secarider/SNAPACK/hardware_manifest_revised.txt

=========================================================
SNAPACK PROJECT GOAL AND
MASTER HARDWARE MANIFEST
WITH BUILD NOTES AND THOUGHTS

=========================================================
PIN MAP REFERENCE
=========================================================
The Authoritative Pin Map Supersedes Any Older Or Conflicting
Pin Number References.
01_Pin_Maps_Authoritative.txt

All ELECROW 2.1 ESP32 Rotary Display 
480x480 HMI IPS Round Knob Touch Display
Pin Numbers Refer To The 12-Pin Ribbon Cable
Connector Pin Numbers Identified By The Silkscreen On The Back
Of The Display PCB.

---------------------------------------------------------
HIGH CURRENT PATH
NEGATIVE SWITCHING ONLY.
POSITIVE PATH REMAINS UNINTERRUPTED.
---------------------------------------------------------
Snapack Design:
The Main High Current Positive Path Remains Uninterrupted.
No High Current Fusing Is Provided For Or Expected.
Esp32 Will Access A Lockout Relay To Force Pos+ Control Voltage Cutoff 
When/If Any Set Variables Are Met. Like Temp Or Voltage Drops.
Low Current Control Lockouts Are Not Included And Are Exempt.
=========================================================
Purpose:
Intelligent 12V LiFePO4 Jump Pack w/ 16V Boost 
With Touchscreen HMI, Contactor Control,
Cell Monitoring, Temperature Monitoring,
Current Monitoring Both In And Out, 
Self-Diagnostics, Logging, And Pack Resistance Tracking.
MAX Amps Hold/Show Info Screen Display
Display AMPS Out And Any AMPS In To Calculate From Last "Set Full" Pack
All Terminating End Of Control And Low Current Supplies,
Will Be In The Service Hatch Area If Possible, We Will See.

=========================================================
            SOURCE BATTERIES
=========================================================
Headway 38120 LiFePO4 Cells
Configuration: 5S5P
Pack Volts: 4S (~12V nominal)
Pack Volts: 5S (~16V nominal)
Estimated:  1000 Amp Output Availibility
110spec Copper Bus-Bars 3/16" Thick Throughout
All Contactor Bus-Bars As Well

=========================================================
            CONTACTORS
=========================================================
   Negative Switching Only.
   Positive Path Remains Uninterrupted.
         ==========\/========

EV200               

Qty: 2 In Parallel

Specs:
500A X 2 For 1000A Capacity

Coil Supply Source:
9–36 V Coil With Economizer Operating Range Per Specs.
Power These From Full Pack Voltage 16V

Protection:
Dedicated Positive-Side Fuse

Processor Lockout:
Series Relay In Contactor Banks Positive Coil Feed So Over Temp, Over Amp, Or ?, 
Will Allow For Automatic Shutdown Via ESP32 Controller Via Opto-Isolated 5v SPDT Relay

Hardware Interlocks:
Negative-Side Switched Control Path

Fail-Safe Behavior:
Opening Either Positive Permission Or Negative Control
De-Energizes Power Path For All Contactor Banks, Both EV200 And Lev100.

Purpose:
Full Pack: 5S (~16V Nominal) Main High-Current Contactors

         ==========/\========
   Negative Switching Only.
   Positive Path Remains Uninterrupted.
         ==========\/========

LEV100

Qty: 8 Total

Purpose:
Battery Tap @ 4S (-12V) High Current Path

Specs:
100A X 8 For 800A Capacity Maybe A Little Light But It Is What It Is.
24V Coils
Power For 24V LEV100 Coils Supplied By:
DC 12V To 24V 3A Step Up Boost Converter: <--Feed This From 16V Full Pack Voltage
This Is A Potted Module So No Coating Needed

Protection:
Dedicated Positive-Side Fuse

Processor Lockout:
Series Relay In Positive Coil Feed So Over Temp, Over Amp, Or ?, 
Will Allow For Automatic Shutdown Via ESP32 Controller

Hardware Interlocks:
Negative-Side Switched Control Path

Fail-Safe Behavior:
Opening Either Positive Permission Or Negative Control
De-Energizes Power Path For All Contactors Banks, Both EV200 And Lev100.

Mounting:
4 In Left Wing
4 In Right Wing
110spec Copper Bus-Bars 3/16" Thick Throughout

         ==========/\========
   Negative Switching Only.
   Positive Path Remains Uninterrupted.

=========================================================
            Interlock And Command RELAYS
=========================================================
Automotive SPDT 12v 30A Relay Sockets Included
Qty:4

Protection:
Dedicated Positive-Side Fuse

EEEEE 1N4007 Rectifier/Flyback Diodes:
Relay Terminals 86+ Are Always Positive Coil Supply; 
Relay Terminals 85- Are Always Negative/Control Return. 
Flyback Diode Stripe Always Faces 86 +.
One Diode Installed Across Pins 85- And 86+ Of Each Relay Coil
To Suppress Inductive Voltage Spikes When The Coil Is De-Energized,
Protecting Relay Contacts And Control Electronics.

De-Pinned Both 86 And 85 From 5 Sockets And
Soldered Directly To Wire Crimps, Stripe Toward 86 +.
Four Automotive Relay Sockets Remain Used In The Current Design.
The Fifth Previously Prepared Gatekeeper Socket Is Replaced By The
5V Opto-Isolated Relay Module.

=========================================================
            CONTACTOR INTERLOCK / BREAK-BEFORE-MAKE
=========================================================
Purpose:
Guarantees The LEV 100 Banks 12v Contactor Releases Before
The 16v EV200 Main Boost Path Contactor Is Allowed To Energize.
Must Work For Both Transition To And Detransition From 16v Boost Function

Theory Of Operation:
1 SPDT 12v In Its Relaxed (Unpowered) State Turns The 12v Lev100 Banks Control Relay To Authorized,
Allowing The Timer Switch Signals To Reach The Controls.
The Open Pole Of Same Double Throw Relay Assures 16v EV200 Contactor Is NOT Authorized. 
This Is Probably Sufficient As A Safety Interlock To Insure Either Contactor Bank Can Never Be On At The Same Time,
However,
There Is Concern For The Amount Of Amps Being Pushed At The Moment Of Commanded Contactor 
Switchover Could Pose A Risk (Even If Small) Of The 2 Voltages Running Into Each Other.
Which Could Weld The Contacts Together Microseconds After The Commanded Switchover.
So It Should Be Simple Enough To Introduce A Controlled Delay Long Enough To Guarantee 
12v Contactor Has Released Before The 16v Contactor Can Engage.
The Resultant Burn Down Of A 5p5s Pack From Such An Unlikely (But Not Zero Chance) Event Could Be Quite Energetic
To Say The Least, So Extra Precautions Are Being Employed By Stretching Out
The Sequence Using 2 Relays To Double The Time Alotted For Contactor Disconnect Before Connect 
" Break For Sure Before Make " And Still Accomplish The Switchover In No Less Than <50ms No More Than >100 milliseconds
And Works For Both Transition To And Detransition From 16v Boost Function.

Function:
12V OFF
    ↓
Delay By Dual Consecutive Relay, NOT DBL Throw, 
An Actual 2nd Relay For Pole/Pivot Transit Travel Time x2 
Best Guess This Will Give Us >50ms Delay, 
This Provides The Same Delay In Both Directions.
Hopefully Preventing Pack Shorting By Contact Overlap 
Resulting In Welded Contactors From An Accidental Make-Before-Break. 
Unlikely, But Not Zero Chance So... Extra Precautions Are Being Employed.
    ↓
16V ON

Location:
Service Hatch

       [ RELAY 1: 12V POLICE ]                   [ RELAY 2: 16V POLICE ]
  ┌────────────────────────────────┐       ┌────────────────────────────────┐
  │ Pin 85: GND                    │       │ Pin 85: GND                    │
  │ Pin 86: 12V Mode Switch Signal │       │ Pin 86: 16V Mode Switch Signal │
  │ Pin 30: Master Control Power   │       │ Pin 30: Master Control Power   │
  │ Pin 87a (NC): Wire to R2 Pin 30│       │ Pin 87a (NC): Wire to R1 Pin 30│
  │ Pin 87 (NO): To LEV100 Coils   │       │ Pin 87 (NO): To EV200 Coils    │
  └────────────────────────────────┘       └────────────────────────────────┘
The 12V Path Logic: 
Run The Main Control Power Into Relay 2, Pin 30. 
Run A Wire From Its Normally Closed Contact (Pin 87a) Over To Relay 1, Pin 30. 
Finally, Run Relay 1'S Normally Open Contact (Pin 87) Out To The LEV100 Contactor Coils.

The 16V Path Logic: 
Mirror The Exact Same Step On The Other Side. Run Main Control Power Into Relay 1, Pin 30. 
Run A Wire From Its Normally Closed Contact (Pin 87a) Over To Relay 2, Pin 30. 
Then, Run Relay 2'S Normally Open Contact (Pin 87) Out To The Big EV200 Contactor Coils.

The ESP32 Output Sense Wire Can Double-Check These Exact Millisecond Speeds During Bench Mockup?

=========================================================
            Processor Commanded Lockout:
=========================================================
The ADS1115 ALERT Output Does NOT Directly Energize A Relay Coil.

A Single-Channel 5V Opto-Isolated Relay Module Is Used As The Interface:
AITRIP 5V One Channel Relay Module
Opto Isolation / High-Low Level Trigger
ASIN: B096M77HCJ

The Module Contains Its Own Relay Driver And Flyback Protection,
So The ADS1115 ALERT Signal Does Not Carry Relay-Coil Current.

The Relay Contacts Are Wired Into The Positive Contactor Authorization Path.
The Authorized State Uses The Relaxed (Non-Powered) Relay Contact Arrangement That Allows The Pack
To Operate Without The Processor Actively Holding A Relay Coil Energized.

Upon A Processor / ALERT Shutdown Command, The Opto Relay Module Is Activated And Interrupts
The Positive Authorization Path And De-Energizes Both Contactor Banks.

This Module Replaces The Previously Proposed Automotive Gatekeeper Relay.

=========================================================
            CURRENT MONITORING
=========================================================
OTC 3500-01 Clamp
2000A Mode Only
OTC_ZERO_OFFSET = 3.620

The OTC 3500-01) Operate On A Strict, Direct Scaling Ratio: 1mV = 1amp

Fixed on 2000A range:
ThumbWheel Calibrated To Zero By Meter And Then Hot Glue Dollip To Imobilize Wheel Adj.
Will Zero From SoftWare In Future

Plan:
Install Internally On Positive Side
JST 9 Pin Header Added To Extend Delicate Clamp Connected Ribbon Cables
8 Factory Pins And 1 Extra
Function: Cable Shield / Drain
Connection: System Ground
Purpose: EMI shield termination only.
Pin 9 Not a signal conductor.
PCB cleaned after soldering.
PCB protected with conformal coating.
Ribbon cable strain-relieved at clamp body.
JST 9 Pin female connector attached to the OEM ribbon cable header from OEM Circuit Board
This created a 8 inch extension for the OEM Circuit Board to exist further away from clamp
Clamp orientation established during mock-up.
3.3v limits have forced orientation to a discharge = DECREASE in voltage as discharge is the most energetic 
Permanent 9V Power Supply Has Been Provided.

This Small OTC Supply Assembly Will Go On The 
Perf-Board With The Voltage Divider

Input Wires From The Waterproof 5 V Buck
Feeding Into A B0509S-1WR3 DC-DC 5V to 9V Isolated Power Converter
Output Wires To The OTC Electronics Battery Connections

The Waterproof 5 V Buck Is A Separate Potted Module And 
Does Not Need To Be Mounted On That Perf-Board.

=========================================================
            PROTECTION
=========================================================
The P6KE18A Is A Transient Voltage Suppressor (TVS) Diode. 
Under Normal Conditions, It Sits Completely Dormant And Invisible. 
However, If A Massive Voltage Spike 
(Like A Starter Motor Inductive Kickback Or A Surface Charge Surge) 
Hits The System, It Snaps Alive Instantly To Clamp And Shunt That Energy Safely 
To Ground Before It Can Travel Down The Small Signal Wires
Because The 5S Full Pack Max Voltage Is 18.25V, 
We Have Selected An 18V TVS To Act As A Threshold Guard.
On The Divider Board Right Before The Signal Hits The Resistors. 
They Belong Directly Across Each Raw Incoming Protected Voltage Sense Line:
The Five Cumulative Battery Taps Plus Final Output Positive And Final Output Negative.
Stripe To Positive With All Of Their Ends At System Ground.

=========================================================
            Analog Front-End Board (Voltage Divider)
=========================================================
ADS1115

Reads:
5 Cumulative Pack Voltages
24 Volt Rail
OTC Current Sensor
Final Output Positive Voltage
Final Output Negative Voltage

B0 = pack negative / system reference
B1 = first cumulative cell tap
B2 = second cumulative cell tap
B3 = third cumulative cell tap
B4 = fourth cumulative cell tap
B5 = pack positive

Individual cell voltages are derived from these cumulative
measurements.

Current proven divider architecture:

B1:
47k high / 18k low

B2:
47k high / 18k low

B3:
47k high / 18k low

B4:
100k high / 10k low

B5:
100k high / 10k low

Design maximum cumulative voltages:

B1 = 3.65 V
B2 = 7.30 V
B3 = 10.95 V
B4 = 14.60 V
B5 = 18.25 V

These values describe the present proven implementation and required
measurement ranges.

============================================================
          ADS1115 AUTHORITATIVE CHANNEL MAP
============================================================
CHANNEL ALLOCATION
============================================================
Board 1 — 0x48 jumper directly between ADDR Pin To SYS GND
A0 = B1 3.3
A1 = B2 6.6
A2 = B3 9.9
A3 = B4 12.8
this is all 4 cells that make 12v on one board

ALERT Wired And Available

------------------------------------------------------------

Board 2 — 0x49 jumper directly between ADDR Pin To 5v+ VDD
A0 = B5 Pack Positive + 16.0
A1 = CDS/light sensor
A2 = OTC Current
A3 = 24 V LEV100 supply monitor

ALERT Wired And Available

------------------------------------------------------------

Board 3 — 0x4A jumper directly between ADDR Pin To SDA

A? =    Final Output +
A? =    Final Output −
two spare channels remaining

ALERT Wired And Available

Board 1 = 0x48 jumper directly between ADDR Pin To SYS GND
Board 2 = 0x49 jumper directly between ADDR Pin To 5v+ VDD
Board 3 = 0x4A jumper directly between ADDR Pin To SDA
Board 4 = 0x4B jumper directly between ADDR Pin To SCL

-------------------------------------------------------

Sense Wire Locations:
Final Output (+): Last Internal Positive Connection Before The Jump Cable Leaves The Pack
Final Output (-): Last Internal Negative Connection Before The Jump Cable Leaves The Pack
Obtain These From Last High Current Connection
Do Not Obtain These From Any Other Location
Use Bigger Wire As Well

The Two Final Output Sense Channels Use The Same
47k / 18k / 100nF / P6KE18A Protected Divider Circuit  ---------------------------------??
As The Five Existing Cumulative Pack Voltage Channels.

Single Row Divider Sketch: 1 Each Protected Voltage Input = x7
(5 Cumulative Pack Voltage Inputs + Final Output Positive + Final Output Negative) =7

               TVS Protection Shield
                    +    |  \/      +        +                    +      +      +
BMS TAP ───| |───────────●──────────────────►[ 47kΩ Resistor ] <───●─WIRE/HOLE────────► To ADS1115 Pin
            |           +│\                /                     +│\                /
            |           +│ * SAME HOLE AS *                      +│ * SAME HOLE AS *                                  
            |           +│    +/\+               +/\+            +│
            |           +│     ││                 ││             +│────────────┐
        Isolation   [ P6KE18A ] \ (Stripe To Pos) /            [ 18kΩ ]     [ 100nF ]
          Relay       TVS Diode                                  Lower        Filter
                   OBSERVE POLARITY                             Resistor     Capacitor
                        -│                                       -│────────────┘      
                        -│                                       -│
                        -│                                       -│           -
SYSTEM GND ──────────────┴────────────────────────────────────────┴──────────────────► SYSTEM GND
                        -                                        -            -
Battery tap
    |
    +---- TVS ---- GND
    |
   47k
    |
    +------------ ADS A0/A1/A2/A3
    |          |
   18k        100nF
    |          |
   GND        GND

ADS A-channel  <-- divider/filter junction -->   COMMON GROUND
                           ^
                           |
                      cell input

The End Of The P6KE18A Diode With The Painted Stripe Must Face Each Positive BMS Tap Wire
All TVS Diodes Terminate At Sys Ground. 

=========================================================
            TEMPERATURE
=========================================================
DS18B20 Probes
Qty: 5

Locations: Temp Sensors
1 Sensor At Main POS Cable Connection: There Is Only 1 Bar-To-Cable Connection On The Positive Path, Sensor Is Located Here.
1 Sensor At Main Neg Location: It Is The First Bar-To-Cable For Neg Line At Cell Interface.
Contactors:  1 Sensor In-Between Or Near EV200 Bus Bar Connections: This Neg Location Is Where The Second Cable-To-Bar 
Connection And Is Also Where The External Jump Cable Will Connect
2 For Lev100 Banks: 1 In Each Wing
Probe Locations Are Approximate And Subject To Last Min Change As Fitting And Access Allows
These Are At Bar-To-Cable Connections Not For Contactor Temps But Cable Connection To Bar Temps
As We Theorize A High Temp At Any Single Connection Point Is Reason To Stop Using The Pack And Investigate

DS18B20 Sensors Daisy-Chain Directly:
3.3V
GND
DATA
Common One-Wire Bus
Sensors Daisy-Chain Directly.

The 3.3V Supply:
The AMS1117-3.3 Regulator Module Is Fed From The Main Regulated 5V Rail.
Its Regulated 3.3V Output Powers The Level Shifter LV Pin, The Five
Temperature Sensor Red VCC Wires, And The Top Of The 4.7kΩ OneWire Pull-Up.

The Data Node:
The Bottom Leg Of The 4.7kΩ Pull-Up Resistor Ties To The Five Yellow
Temperature Sensor Data Wires And Output Header Pin 8.
Output Header Pin 8 Routes To 12-Pin Ribbon Pin 6 (TX).

The Ground Node:
The Five Black Temperature Sensor Wires And AMS1117 Ground Return
To System Ground.

AMS1117-3.3 REGULATOR NOTES

Input:
Main Regulated 5V Rail

Ground:
System Ground

Output:
Regulated 3.3V Rail

The Selected AMS1117-3.3 Module Includes Its Own Onboard
Input / Output Bypass Components.

=========================================================
            TIMING: Pack Time On
      This Is NOT Contactor Lockout Timing
=========================================================
Briidea Livewell Timer Switch ASIN 	B0F5H3MDRS
Marine Quality Livewell Switch With 
1-12 Min Rotary Adjustment Knob
Rocker Switch Center Off, Timer, *Always On* <----*
* Remove Continuous ON Position To Ensure Pack Can NEVER Be Left On 
And Will ALWAYS Turn Itself Off After Timer Expires*
Depending On Switch Mount Location 
A Different Switch Can Be Employed
So No Dead Zone Switch Need Be Used As 
The Switch In This Timer Module Is Removable. Yay!

Leave:
OFF And TIMER Positions Active Only
This Is The Main Arm/Disarm Switch.
Knob Should Be Turned Down All The Way For Storage 
So Even If Button Is Bumped On Pack Will Still Not 
"Stay" On Long And Automaticlly Turns It Self Off.

=========================================================
            USB / ACCESSORIES External User Access
=========================================================
12V Accessory Socket
USB-A / USB-C Charger With Voltmeter
Actual Retro 12V Cigarette Lighter , maybe , not
Wing LED Lights
All Power Is Constrained By The Timer, 
Even Power To These Accessories.
There Will Be No Paths Of Power That Can 
Lead To Accidental Pack Depletion.

=========================================================
            DISPLAY / CONTROLLER
=========================================================
ELECROW ESP32-S3 Round Display
Model Number 	DHE03921D
480x480 Touchscreen

Rotary Encoder:
(Push + Rotate)
Depending On Installation Difficulty 
It May Be Display ONLY Without Push Or Rotate
It Is A Touch Screen So Will Still Be Functional Enough For Our Needs

Removable Cable Harnesses:
(NO Soldering Directly To Display PCB)
PCB Has Plugs For Connecting Power And Signal But 
We Now Have The 12Pin Ribbon Cable For All Connections In One Breakout Board
The Ribbon Connector At The Display Is Very Weak 
Don't Be Rough Or You Won't Have A Locking Tab For Your Ribbon Cable
The Breakout Board Has A much More Usable Locking Tab So Disconnect From It If You Can
So That Is Going To Be Our Disconnect 
And Perhaps Still Think About A Light Conformal Coating For The Display PCB To Help 
Weather-Resist It And These Connections From Dirt, Humidity And The Green Crusties

12-Pin Ribbon Connector Pin Map:

See:
01_Pin_Maps_Authoritative.txt

All Pin Numbers Refer To The Silkscreen Numbering On The Back Of
The ELECROW Display PCB. The Breakout Board Is A Straight-Through
Extension And Does Not Introduce A Separate Pin Numbering System.

Keep In Mind Any Connection To A "Live" Side
Should Be The Female Connection.
Male Connects For Passive Side.

=========================================================
            WIRE NUMBER INDEX
=========================================================

Wire Numbering Paradigm:

Single Digit Number Indicates The System / Section Origin.
The Two-Digit Number Identifies The Individual Physical Wire
Within That System.

Wire Numbers Are Assigned To Physical Conductors, Not Merely
To Functions Or Devices.

The List Below Is The Current Working Wire Plan.
Individual Entries Should Be Verified Against The Physical
Build During Mockup And Assembly.

Worksheet Info To Verify For Each Wire:

Wire No:
Signal Name:
Source Device And Terminal:
Destination Device And Terminal:
Normal/Default Voltage Or State:
Wire Color If Helpful:
Wire Gauge If Helpful:
Connector And Pin:
Notes:

1.xx-  Low Current Lockout Control Relays

1.01    +12V Relay Supply
1.02    Ground Relay Supply
1.03    12V Permission Relay Coil +
1.04    12V Permission Relay Coil -
1.05    16V Permission Relay Coil +
1.06    16V Permission Relay Coil -
1.07    Break-Before-Make Timer Input
1.08    Break-Before-Make Timer Output
1.09    Processor Lockout / ADS1115 ALERT Control
1.10    Processor Lockout Relay Status

2.xx-  High Current Contactor Coils / Feedback

2.01    EV200 Coil +   Full Pack Voltage 16V Is Used To Fire These
2.02    EV200 Coil -

LEV100's Use 24VDC Coils Supplied From A 12V To 24V Converter

2.10    LEV100 Coil Supply +
2.11    LEV100 Coil Return -

LEV100 Auxiliary Contact Wiring:
Reserved Pending Physical Implementation And Verification.

3.xx-  Temperature Sensors

3.01    OneWire DATA
3.02    +3.3V
3.03    System Ground

Temperature Sensor Identification / Location:

3.10    POS+ Bus Sensor
3.11    NEG- Bus Sensor
3.12    EV200 Bus Sensor
3.13    LEV Left Sensor
3.14    LEV Right Sensor

3.10 Through 3.14 Identify The Five Physical Sensors / Locations.
They Do Not Represent Five Additional OneWire Data Conductors.

4.xx-  Display

4.01    +5V
4.02    System Ground
4.03    SCL
4.04    SDA
4.05    Temperature Sensor DATA / Display TX

USB D+ And D- Are Unconnected And Therefore Are Not Assigned
Physical Wire Numbers Here.

5.xx-  Battery / Voltage Sense

5.01    B0 / Pack Ground
5.02    B1
5.03    B2
5.04    B3
5.05    B4
5.06    B5

5.10    Final Output Voltage Sense (+)
        Final Positive Connection Before Jump Cable Leaves Pack
        → Output Header Pin 9
        → Protected Divider
        → ADS1115 Board 2 A1

5.11    Final Output Voltage Sense (-)
        Final Negative Connection Before Jump Cable Leaves Pack
        → Output Header Pin 10
        → Protected Divider
        → ADS1115 Board 2 A3

6.xx-  Accessory Power

DC 5V, 9V, And 24V Arrive From Dedicated Onboard
Buck / Boost Supplies, NOT Direct Battery Taps.
12V And 16V Are Battery Tapped.

6.01    5V Main
        5VDC Output From 12V To 5V Converter

6.02    5V Ground
        Same As System Ground

6.03    9V Isolated +
        OTC Amp Clamp Power +

6.04    9V Isolated -
        OTC Amp Clamp Power -

6.05    24V LEV100 +
        Output From 12V To 24V Converter

6.06    24V LEV100 -
        Same As System Ground

6.07    12V Raw
        Direct Battery Tap
        Powers Onboard Converters

6.08    12V Ground
        Same As System Ground

6.09    3.3V Regulated
        AMS1117-3.3 Output

6.10    3.3V Ground
        Same As System Ground

7.xx-  Current Sensor (OTC)

7.01    OTC Analog Signal
        OTC Sensor Output → ADS1115 Board 2 A2

7.02    OTC Isolated -9V / Signal Return

7.03    OTC Isolated +9V

7.04    OTC Cable Shield / Drain
        → System Ground At Electronics End

8.xx-  User Controls

8.01    Main Timer Switch
8.02    BOOST Button
8.03    ARM Switch
8.04    Service Override (Reserved)

9.xx-  Future Expansion

LEV100 Auxiliary Contact Input
Reserved Pending Physical Implementation And Verification.

Heater Pad Integration
Reserved If Adopted.

=========================================================
            WIRE NUMBER VERIFICATION
=========================================================

During Mockup / Final Assembly:

Verify That Each Number Represents A Real Physical Conductor.

Verify Source And Destination With The Meter Where Applicable.

Record Connector And Pin Assignments.

Record Wire Color And Gauge Where Useful.

Remove Any Planned Entry That Does Not Exist In The
Completed Physical Build.

Once Verified, This Index Becomes The Source For:

09_Wire_Number_Index.txt

=========================================================
------------------------------------------------------------
24V LEV100 COIL-SUPPLY MONITORING
------------------------------------------------------------

A Dedicated Protected Divider Shall Be Used Because The Existing
47k / 18k Pack-Voltage Divider Is Not Suitable For The 24V Rail.

24V RAIL ─────────●────────► [100kΩ] ─────●────► ADS1115 Board 3 / A0
      SAME HOLE AS│                       │SAME HOLE AS
                [TVS]P6KE27A            [10k]
                  │    SAME HOLE AS       │
SYSTEM GND ───────┴───────────────────────┴────► SYSTEM GND

Candidate Divider Pending Converter Maximum-Voltage Verification:

Upper Resistor: 100k
Lower Resistor: 10k
Filter Capacitor: 100nF

A Higher-Voltage TVS Appropriate For The 24V Rail Shall Replace
The P6KE18A Used On The Existing Lower-Voltage Sense Channels.

P6KE27A
Axial Unidirectional Channel 600 Watt 27 Volt TVS Transient Suppression Diodes 

========================================================================================================================
BMS ISOLATION RELAY 12V SUPPLY

The Isolation Relays Energize Whenever SNAPACK Is Powered.
Processor Authorization Is Not Required.

========================================================================================================================

AMBIENT LIGHT SENSOR / AUTOMATIC DAY-NIGHT DISPLAY THEME:

Sensor:
GL5528 5mm CdS Photoresistor / LDR

GL5528 Relevant Specifications:
Light Resistance @ 10 Lux: 10-20kΩ
Spectral Peak: 540nm
Maximum Voltage: 150V DC
Maximum Dissipation: 100mW
Operating Temperature: -30°C To +70°C

Purpose:
Provides Ambient-Light Level To The ESP32 Through ADS1115 Board 3.
Firmware Uses The Reading To Select Between Day And Night Display Themes.

The Sensor Is Not Intended To Measure Calibrated Lux.
Actual Day/Night Switching Thresholds Will Be Established In Firmware
Using Readings From The Finished Installation.

Voltage Divider:

Regulated 3.3V
     |
 [ GL5528 ]
     |
     +--------------------> ADS1115 Board 3 / A1
     |
   [ 10kΩ ]
     |
  SYS GND

Physical Light Pipe:

3/16" (4.76mm) Clear Acrylic Round Rod
Used As A Light Pipe From The Exterior Of The SNAPACK Enclosure
To The 5mm Face Of The Internally Mounted GL5528.

The Exterior End Of The Acrylic Rod Is Exposed To Ambient Light.
The GL5528 Remains Inside The Enclosure.

The Interior Length Of The Acrylic Rod May Be Covered With Opaque
Tubing Or Black Heat-Shrink To Reduce Light Pickup From The Display
And Other Internal Light Sources.

========================================================================================================================
        PROPOSED / UNDER CONSIDERATION
========================================================================================================================

The Following Items Are Design Concepts Under Evaluation.
They Are Not Yet Implemented Hardware And Shall Not Supersede
The Authoritative Built-Hardware Specifications Until Adopted.

------------------------------------------------------------
PROCESSOR-FAILURE MANUAL OVERRIDE
------------------------------------------------------------

Consider External Weather-Resistant Key Switch Providing
Manual Bypass Of Processor Authorization.

Purpose:

Permit Basic Manual Pack Operation If The ESP32 / Display /
Controller System Is Unavailable.

The Override Would Restore Manual Authorization while retaining
the existing hardware interlock / mode-selection architecture.

Final Switch, Wiring, And Implementation Not Yet Selected.

PROPOSED FEATURE — POST-CRANK RECOVERY / VEHICLE CHARGING

After a successful cranking event, 
SNAPACK may remain connected to the running vehicle and monitor charging current returning from the vehicle charging system.

- Track charge removed during cranking by integrating current over time.
- After engine start, detect current returning to SNAPACK and track recovered charge.
- Display recovery progress and provide a clear indication when the energy used during the crank has been recovered.
- Cells 1–4 / normal 12V section receive charge directly from the vehicle.
- If the 12V section has recovered but Cell Group 5 / boost cell remains low, 
a future small internally controlled isolated LiFePO4 charger may transfer energy from the 12V section to Cell 5.
- This could provide a simple field-charging method: connect SNAPACK to a running vehicle and allow 
SNAPACK to manage its own recovery without specialized shop charging equipment.
- Specialized direct BMS/cell charging remains available for full service/balancing via 6s BMS leads at service hatch

AUTOMATIC DISCONNECT

During vehicle charging/recovery, continuously monitor:
- Charge current and direction
- Individual cell voltages
- Pack voltage
- Temperature sensors
- Recovered charge

When the desired recovery level is reached, or if a configured voltage/current/temperature limit is reached, SNAPACK may remove the authoritative positive relay authorization and open the main contactors, automatically disconnecting itself electrically from the vehicle.

Normal completion and fault-triggered shutdown should be separately identified and logged/displayed.

12-MINUTE HARD LIMIT

The existing 12-minute hardware timer remains authoritative and should not be bypassed for charging.

Software may terminate recovery earlier, but may not extend operation beyond the timer.

The 12-minute window already provides substantial potential recovery from a normally operating vehicle 
charging system and preserves the original hardware-enforced maximum connection time.

CRANKING-SCREEN TEMPERATURE DISPLAY

During an active cranking event, reserve an area near the large cranking-current display for a temperature display
Occupied By The Hottest Sensor And Its #

Normally display average pack temperature or a subdued temperature indication.

If an individual temperature sensor becomes abnormal or begins rising rapidly during a sustained crank, 
immediately replace the normal indication with the affected sensor name and temperature so the 
developing condition is visible without leaving the cranking screen.

CELL 5 MAINTENANCE / TOP-OFF MODE

The proposed isolated Cell-5 LiFePO4 charger does not need to operate only during post-crank vehicle recovery.

Because Cell 5 top-off current will likely be relatively low (~1 A), Cell 5 may recover incrementally over multiple SNAPACK operating sessions.

A user may deliberately activate a normal 12V timer cycle while no vehicle is connected specifically to allow the 12V Cells 1–4 section to top off Cell 5.

Possible logic:

- Normal 12-minute SNAPACK timer is activated.
- No cranking or external vehicle-charging event is occurring.
- Firmware checks Cells 1–4 and Cell 5.
- If the 12V section has adequate available charge and Cell 5 is below its defined target, enable the isolated Cell-5 charger.
- Display indicates BOOST CELL TOP-OFF / Cell 5 voltage / charging status.
- Charger terminates normally when Cell 5 reaches its proper charge condition.
- Existing 12-minute hardware timer remains the absolute maximum session duration.
- Additional 12-minute maintenance sessions may be initiated later if Cell 5 still requires charging.

This allows Cell 5 maintenance while SNAPACK is being transported between jobs and reduces the importance of completing Cell-5 recovery during a single vehicle-charging session.

PROPOSED FEATURE — FIVE-CHANNEL SERVICE CHARGER

Possible future replacement for the present manual five-power-supply charging procedure.

Concept:
- Provide one external DC service-power connection.
- Internally split that source among five independent isolated DC/DC converters.
- Each isolated converter powers one dedicated 1S LiFePO4 charger such as the SK3624 3.6V / 2.4A module.
- Each charger independently charges one 1P5S cell group:

  Charger 1 → B0-B1
  Charger 2 → B1-B2
  Charger 3 → B2-B3
  Charger 4 → B3-B4
  Charger 5 → B4-B5

- The five isolated converter INPUTS may share the same external power source.
- Their OUTPUTS remain isolated so each charger can float at its respective position in the series pack.
- Individual chargers may terminate as their respective cell groups become full while the remaining groups continue charging.
- Approximate maximum combined cell-charging power at 2.4A/channel is ~43W, before conversion losses.

PACKAGING OPTIONS:

1. INTERNAL:
   Five isolated converters + five charger modules installed inside SNAPACK.
   User connects only one ordinary external service-power supply.

2. EXTERNAL:
   If enclosure space becomes insufficient, place the complete five-channel isolated charger system in a dedicated external service-charger box.
   Connect that charger to SNAPACK through the existing B0-B5 service/BMS connection.

This is separate from the proposed automatic onboard Cell-5 recovery charger used during post-crank/maintenance operation.

STATUS: CONCEPT / PACKAGING STUDY
Final implementation depends primarily on available enclosure space.

more charging thoughts 
Board 2 ALERT + pull-up + another AITRIP 5 V opto relay is a very plausible charger-control path.

PROPOSED — AUTOMATIC CELL-5 CHARGE / RECOVERY HARDWARE

PURPOSE

Provide an onboard method of charging Cell Group 5 (B4-B5) from the
normal 12V section without requiring the normal 12V and Cell-5 grounds
to be common.

This supports:
- Post-crank Cell-5 recovery
- Intentional Cell-5 maintenance/top-off sessions
- Opportunistic Cell-5 charging whenever operating conditions permit

PROPOSED POWER PATH

12V section / available SNAPACK power
        |
        v
Cincon EC5DAW-24S05N isolated DC/DC
        |
        |  Isolated regulated 5V / 2A / 10W
        v
SK3624 1S LiFePO4 charger
        |
        +---- BAT+ -> B5
        |
        +---- BAT- -> B4

Cincon EC5DAW-24S05N:
- Input: 9-36VDC
- Output: regulated 5V / 2A
- Power: 10W
- Galvanically isolated
- May therefore be powered directly from the 12V section or from the
  existing 24V rail.

SK3624 charger:
- 1S LiFePO4
- 4.5-5.5V input
- 3.6V charge cutoff
- Up to approximately 2.4A charging
- Internal CC/CV charging and termination
- Approximately 200mA termination threshold
- Automatic recharge below approximately 3.5V

The isolated converter allows the complete SK3624 charger circuit to
float at B4 potential.

CELL-5 CHARGER CONTROL

ADS1115 Board 2 already monitors B5:

Investigate using Board 2 ALERT as the authoritative Cell-5 charger enable/disable signal.

ADS1115 ALERT is open-drain:
- Asserted = actively pulls LOW
- Inactive = releases line / high impedance
- External pull-up establishes HIGH state when released

Proposed control:

Board 2 ALERT
      |
   pull-up
      |
      v
Low-level-trigger opto-isolated relay/control stage
      |
      v
Cell-5 charger power authorization

Desired logic:
- ALERT released / HIGH = CHARGER OFF
- ALERT asserted / LOW = CHARGER ON

Therefore loss of ADS1115 power/configuration or an open ALERT signal
naturally results in charger OFF.

The ESP32 does not directly drive ALERT. It commands Board 2 over the
existing SDA/SCL I2C bus and can rapidly rewrite the ADS1115 comparator
configuration/threshold registers.

Board 2 may continue scanning its four analog channels normally.
When firmware determines that Cell-5 charging is appropriate, it may
reconfigure Board 2 ALERT for the charger-control function.

The SK3624 remains responsible for the actual LiFePO4 CC/CV charging
and normal charge termination. SNAPACK controls whether the charging
subsystem is authorized to operate.

IMPLEMENTATION NOTE

Before finalizing this scheme, bench-test that Board 2 ALERT can be
reliably commanded into both required states through ADS1115 register
configuration while retaining the required multi-channel scanning
behavior.

STATUS: PROPOSED / BENCH TEST REQUIRED
