secarider/SNAPACK/Documentation/10_Hardware_Revision_Log.txt

============================================================
10_HARDWARE_REVISION_LOG.TXT
============================

Revision History

Rev A

Initial Prototype

Rev B

• AMS1117 3.3V Regulator
• Final Output Voltage Sense
• Opto-Isolated ALERT Relay
• Corrected Connector Pin Mapping
• Modular Hardware Specifications

Rev C

• ADS1115 Analog System Changed To 3.3V Operation
• I2C Level Shifter Removed
• Three ADS1115 Board Architecture Established
• Voltage Divider Networks Revised For 3.3V Analog System
• DS2484 I2C-To-1-Wire Temperature Interface Added
• ADS1115 ALERT / AITRIP Contactor Authorization Retained

============================================================

SNAPACK Hardware Specification

Status: Authoritative
Revision: Active

============================================================
PURPOSE
=======

This Specification Records Significant Hardware
Design Changes Made Throughout The SNAPACK Project.

Only Completed And Implemented Hardware Changes
Shall Be Recorded.

============================================================
REVISION FORMAT
===============

Revision

Date (Optional)

Summary

Affected Specifications

Notes (Optional)

============================================================
REVISION HISTORY
================

Revision A

Initial Prototype Construction

---

Revision B

Authoritative Connector Pin Mapping Established

Affected Specifications

01_Authoritative_Pin_Mapping.txt

---

Revision B

Dedicated AMS1117-3.3 Regulated Supply Added

Affected Specifications

02_Power_Architecture.txt

---

Revision B

Final Output Positive Voltage Monitoring Added

Affected Specifications

04_ADS1115_Analog_Front_End.txt

---

Revision B

Final Output Negative Voltage Monitoring Added

Affected Specifications

04_ADS1115_Analog_Front_End.txt

---

Revision B

ADS1115 ALERT Output Changed To Operate Through
AITRIP 5V Opto-Isolated Relay Module

Affected Specifications

04_ADS1115_Analog_Front_End.txt

08_Protection_And_Fault_Response.txt

---

Revision B

Five Temperature Sensor Locations Finalized

Affected Specifications

06_Temperature_Monitoring.txt

---

Revision B

Modular Hardware Specification Set Created

Affected Specifications

All

============================================================
REVISION C
==========

ADS1115 Analog System Changed From 5V To 3.3V Operation

The ADS1115 Boards Now Operate Directly From The
Regulated 3.3V Logic Rail.

Affected Specifications

01_Authoritative_Pin_Mapping.txt

02_Power_Architecture.txt

03_Display_Interface.txt

04_ADS1115_Analog_Front_End.txt

---

I2C Level Shifter Removed

The ADS1115 Analog System And Display I2C Interface
Now Operate In The Same 3.3V Logic Domain.

The Previously Required I2C Level Shifter Is No Longer
Part Of The SNAPACK Hardware Architecture.

Affected Specifications

01_Authoritative_Pin_Mapping.txt

02_Power_Architecture.txt

03_Display_Interface.txt

04_ADS1115_Analog_Front_End.txt

---

Three ADS1115 Board Architecture Established

Three ADS1115 Boards Are Used To Provide The Required
Analog Measurement Channels.

The Third ADS1115 Provides Channels For Final Output
Voltage Monitoring And Additional Expansion Capacity.

Affected Specifications

01_Authoritative_Pin_Mapping.txt

03_Display_Interface.txt

04_ADS1115_Analog_Front_End.txt

---

Voltage Divider Architecture Revised

The Previous Common Divider Arrangement Was Revised
For Operation With The 3.3V ADS1115 Analog System.

Current Divider Architecture:

B1 = 47k High / 18k Low

B2 = 47k High / 18k Low

B3 = 47k High / 18k Low

B4 = 100k High / 10k Low

B5 = 100k High / 10k Low

24V Rail Monitor = 100k High / 10k Low

The First Three Cumulative Battery Taps Retain The
Previously Proven 47k / 18k Divider Network.

The Higher Voltage Measurement Channels Use The
100k / 10k Divider Network To Maintain Suitable
ADS1115 Input Voltage At Their Maximum Design Voltage.

Affected Specifications

01_Authoritative_Pin_Mapping.txt

04_ADS1115_Analog_Front_End.txt

---

DS2484 I2C-To-1-Wire Interface Added

The Temperature Sensor Interface Now Uses A DS2484
I2C-To-1-Wire Bridge.

The DS2484 Operates From The Regulated 3.3V Rail
And Communicates With The ESP32 Through The Shared
3.3V I2C Bus.

The DS18B20 Temperature Sensors Operate On The
OneWire Bus Downstream Of The DS2484.

The Previous Direct ESP32 OneWire Temperature
Connection Is No Longer Used.

Affected Specifications

02_Power_Architecture.txt

03_Display_Interface.txt

06_Temperature_Monitoring.txt

---

ADS1115 ALERT Hardware Authority Retained

ADS1115 Board 1 ALERT Continues To Operate Through
The AITRIP 5V Opto-Isolated Relay Module.

The AITRIP Relay Interrupts Positive Contactor Coil
Authorization During Hardware Fault Conditions.

The ADS1115 ALERT Output Does Not Directly Drive
The Contactor Coil.

Affected Specifications

04_ADS1115_Analog_Front_End.txt

08_Protection_And_Fault_Response.txt

---

Developmental Perfboard Connector Pin Assignments Retired

Connector Pin Numbers Used On Developmental Perfboards
Are Not Considered Permanent SNAPACK Connector Assignments.

The Current Development Boards Will Not Be Installed
As The Final SNAPACK Hardware.

Final Connector And PCB Pin Assignments Shall Be
Established During Manufactured PCB Development.

No Final PCB Pin Numbers Are Assigned At This Revision.

Affected Specifications

01_Authoritative_Pin_Mapping.txt

============================================================
REVISION POLICY
===============

Only Completed Hardware Changes Shall Be Added
To This Log.

Planned Features Shall Not Be Recorded Until
Implemented.

============================================================
END OF SPECIFICATION
====================
