secarider/SNAPACK/Documentation/01_Pin_Maps_Authoritative.txt

============================================================
            PIN NUMBERING CONVENTION
============================================================

Unless Specifically Stated Otherwise:

All ELECROW Display Pin Numbers Refer To The 12-Pin Ribbon Cable
Connector Pin Numbers As Identified By The Silkscreen On The Back
Of The Display PCB.

The Ribbon Breakout Board Is Treated Strictly As A Straight-Through
Extension Of The Display Ribbon Cable. However,
A 3 Pin JST Female Connector/Header Has Been Attached To The 
Breakout Board At Pins D+, D-, Ground. !! NO POWER LINE !!
A Corresponding USB Type A Plug Has Been Fitted With 
The Matching Connection To Create A Computer/Flashing Path
That Does Not Interfere With The Packs Normal Power Paths.

Breakout Board Pin Numbers Are Intentionally NOT Used In This
Manifest Unless Absolutely Required For Physical Construction.

============================================================
          ADS1115 AUTHORITATIVE CHANNEL MAP
============================================================
CHANNEL ALLOCATION
============================================================
Board 1 — 0x48 jumper directly between ADDR Pin To SYS GND
A0 = B1
A1 = B2
A2 = B3
A3 = B4
this is all 4 cells that make 12v on one board

ALERT Wired And Available

------------------------------------------------------------

Board 2 — 0x49 jumper directly between ADDR Pin To VDD
A0 = B5 Pack Positive +
A1 = CDS/light sensor
A2 = OTC Current
A3 = 24 V LEV100 supply monitor

ALERT Wired And Available

------------------------------------------------------------

Board 3 — 0x4A jumper directly between ADDR Pin To SDA
A? =    Final Output +
A? =    Final Output −
two spare channels remaining

ALERT Wired And Available

Board 1 = 0x48 Jumper Directly Between ADDR Pin To SYS GND
Board 2 = 0x49 Jumper Directly Between ADDR Pin To VDD
Board 3 = 0x4A Jumper Directly Between ADDR Pin To SDA
Board 4 = 0x4B Jumper Directly Between ADDR Pin To SCL

------------------------------------------------------------

Voltage Divider For 1s, 2s, 3s, BMS Taps

               TVS Protection Shield
                    +    |  \/      +  \/ No Polarity \/ Concerns Here                              
BMS TAP ─| |───────────●──────────────────►[ 47kΩ Resistor ] <───●─WIRE/HOLE────────► To ADS1115
          |            │\                /                      │\                /
          |           +│ * SAME HOLE AS *                       │ * SAME HOLE AS *                                  
          |            │(Stripe To Pos)                         │     < - < - No Polarity Concerns Here
          |           +│                                        │────────────┐
      Isolation   [ P6KE18A ]                                [ 18kΩ ]     [ 100nF ]
        Relay       TVS Diode                                  Lower        Filter
                 OBSERVE POLARITY                             Resistor     Capacitor
                      -│                                        │────────────┘      
                       │                                        │      < - < - No Polarity Concerns Here
                      -│      < - - SAME HOLE AS -  -  >        │
SYSTEM GND ────────────┴────────────────────────────────────────┴──────────────────► SYSTEM GND

=======================================================================================================================

Voltage Divider For 4s, 5s, and 24volt Rail Monitor

                    +                         +
24V RAIL ─────────────────────●─────────────────► [100kΩ] ─────●──────────► ADS1115
                              │                                │/\
                              │                                │
            SAME HOLE AS      │+                               │SAME HOLE AS
   OBSERVE POLARITY HERE -> [TVS]P6KE27A                     [10k] <- No Polarity Concerns Here
                              │                                │
                              │                                │
                  -          -│   < - - SAME HOLE AS -  -  >   │ \/   
SYSTEM GND ───────────────────●────────────────────────────────●───────────► SYSTEM GND

=======================================================================================================================

CDS Cell:Ambiant Light Sensor

Regulated 3.3V
     +
     |
     |
 [ GL5528 ]   < - < - No Polarity Concerns Here
     |
     --------------------> ADS1115
     |
   [ 10kΩ ]   < - < - No Polarity Concerns Here
     |
  SYS GND

OTC divider ------------------?

=======================================================================================================================

       [ RELAY 1: 12V POLICE ]                   [ RELAY 2: 16V POLICE ]
  ┌────────────────────────────────┐       ┌────────────────────────────────┐
  │ Pin 85: 12V- Mode Switch Signal│       │ Pin 85: 16V- Mode Switch Signal│
  │ Pin 86: Pos+ From CPU Auth     │       │ Pin 86: Pos+ From CPU Auth     │
  │ Pin 30: Master Control Power   │       │ Pin 30: Master Control Power   │
  │ Pin 87a (NC): To Relay 2 Pin 30│       │ Pin 87a (NC): To Relay 1 Pin 30│
  │ Pin 87  (NO): To LEV100 Coils  │       │ Pin 87  (NO): To EV200 Coils   │
  └────────────────────────────────┘       └────────────────────────────────┘

Master Control Power
        │
        ▼
Relay 2 pin 30
        │
        ▼
Relay 2 pin 87a (NC)
        │
        └──────────────► Relay 1 pin 30
                              │
                              ▼
                        Relay 1 pin 87 (NO)
                              │
                              ▼
                         LEV100 coils

Master Control Power
        │
        ▼
Relay 1 pin 30
        │
        ▼
Relay 1 pin 87a (NC)
        │
        └──────────────► Relay 2 pin 30
                              │
                              ▼
                        Relay 2 pin 87 (NO)
                              │
                              ▼
                          EV200 coils
