secarider/SNAPACK/Documentation/09_Wire_Number_Index.txt

============================================================
      09_WIRE_NUMBER_INDEX.TXT
============================================================

Purpose

Master Wire Reference.

Columns

Wire Number

Source

Destination

Signal

Wire Color

Notes

============================================================

SNAPACK Hardware Specification

Status: Authoritative
Revision: Draft 1

============================================================
PURPOSE
============================================================

This Specification Defines The Master Wire Number
Index For SNAPACK.

Every Permanently Installed Wire Shall Have A
Unique Wire Number.

This Document Serves As The Master Cross Reference
For All Electrical Wiring.

============================================================
WIRE IDENTIFICATION STANDARD
============================================================

Each Wire Entry Shall Include

Wire Number

Wire Color

Wire Gauge

Signal Name

Source

Destination

Specification Reference

Notes (Optional)

============================================================
WIRE NUMBER FORMAT
============================================================

Wire Numbers Shall Be Sequential.

Each Number Shall Refer To One Physical Wire Only.

Wire Numbers Shall Not Be Reused.

============================================================
MASTER WIRE INDEX
============================================================

Wire No.

Color

Gauge

Signal

Source

Destination

Reference

Notes

------------------------------------------------------------

0001

------------------------------------------------------------

0002

------------------------------------------------------------

0003

------------------------------------------------------------

0004

------------------------------------------------------------

Continue As Required

============================================================
NAMING CONVENTIONS
============================================================

Signal Names Shall Match The Terminology Used
Throughout SNAPACK Hardware Specifications.

Examples

System Ground

5V Rail

3.3V Rail

B1

B2

B3

B4

B5

SCL

SDA

OneWire

ADS ALERT

Authorization

============================================================
DESIGN NOTES
============================================================

One Wire Number Shall Represent One Physical Wire.

Wire Numbers Shall Remain Constant Even If
Connector Pin Assignments Change.

============================================================
VERIFICATION
============================================================

Verify

□ Every Wire Number Is Unique

□ Every Wire Appears Only Once

□ Source Matches Destination

□ Specification Reference Correct

□ Wire Color Recorded

□ Wire Gauge Recorded

============================================================
END OF SPECIFICATION
============================================================
