secarider/SNAPACK/Firmware/bin_backup/2026-09-13_07-55-39/INFO.txt

SNAPACK firmware archive
Created: Sun Sep 13 07:55:39 AM CDT 2026

Original build directory:
/home/valued/Arduino/snapack/build/esp32.esp32.esp32s3

ESP32 Arduino core boot_app0 source:
/home/valued/.arduino15/packages/esp32/hardware/esp32/2.0.14/tools/partitions/boot_app0.bin

Flash parameters:
chip=esp32s3
port=/dev/ttyACM0
flash_mode=dio
flash_freq=80m
flash_size=16MB

Addresses:
0x0000  snapack.ino.bootloader.bin
0x8000  snapack.ino.partitions.bin
0xe000  boot_app0.bin
0x10000 snapack.ino.bin
