secarider/SNAPACK/images/random/readme.md

# SNAPACK Image Gallery

<p align="center">
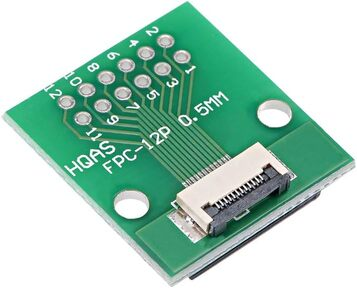
[picture p5: images/random/12Pin_Breakout_board.jpg]
  
  
</p>

<p align="center">
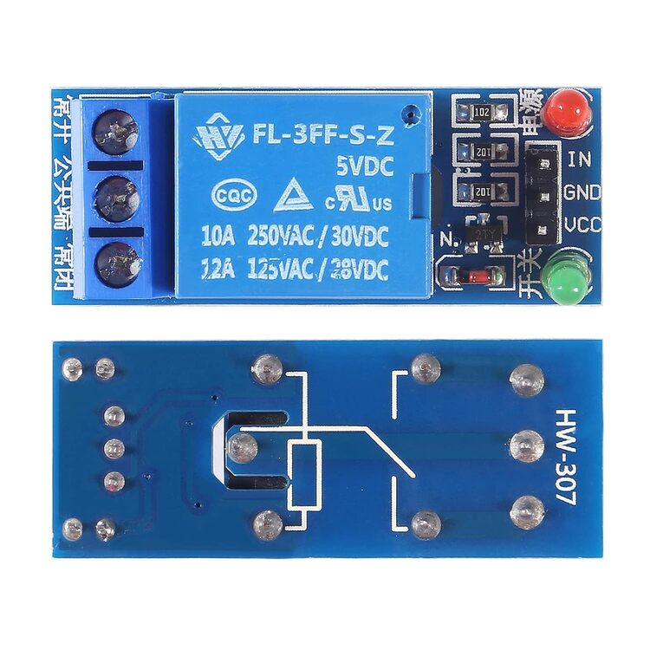
[picture p6: images/random/5V_4A_OPTO_Pos_Auth_Relay.jpg]
  
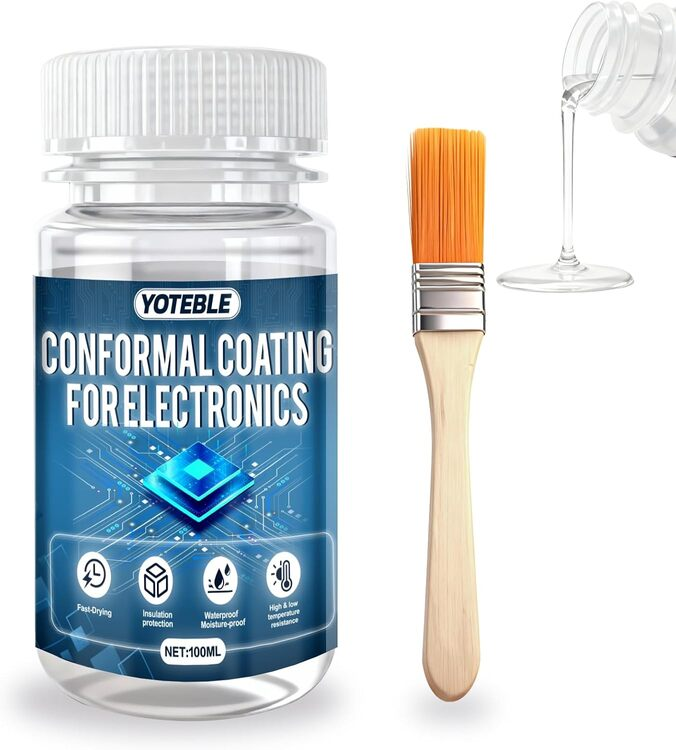
[picture p7: images/random/Conformal_Coating.jpg]
  
</p>

<p align="center">
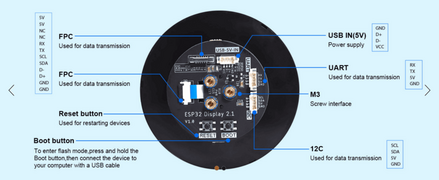
[picture p8: images/random/Display_back.png]
  
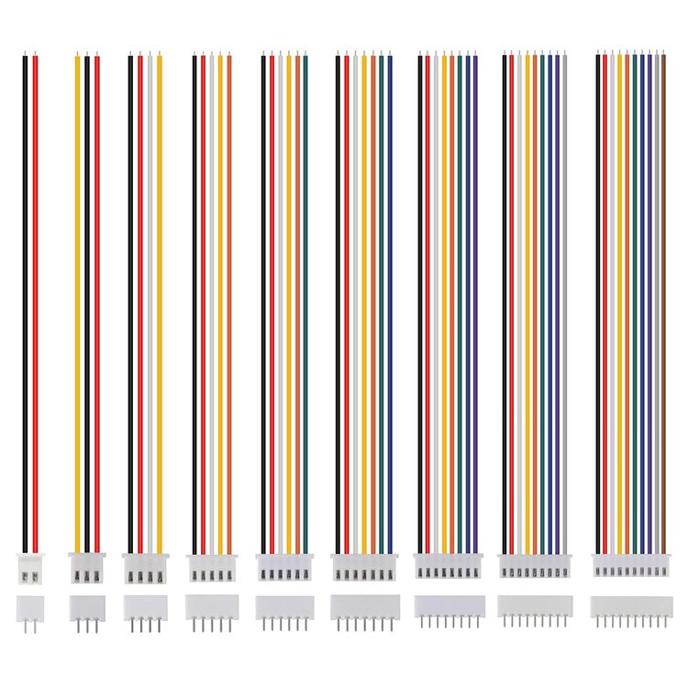
[picture p9: images/random/Header_Connectors.jpg]
  
</p>

<p align="center">
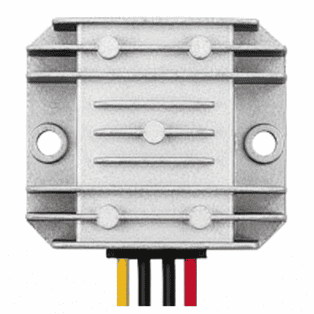
[picture p10: images/random/IMG_12V_to_24V.png]
  
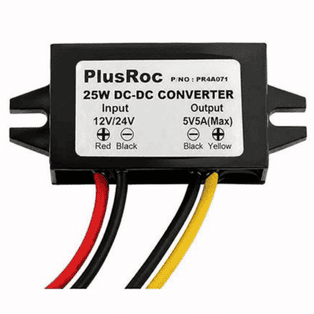
[picture p11: images/random/IMG_12V_to_5V_5A.png]
  
</p>

<p align="center">
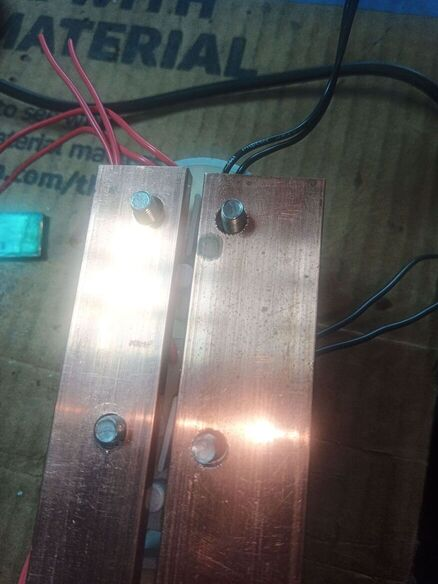
[picture p12: images/random/LEV100_Bus_Bars.jpg]
  
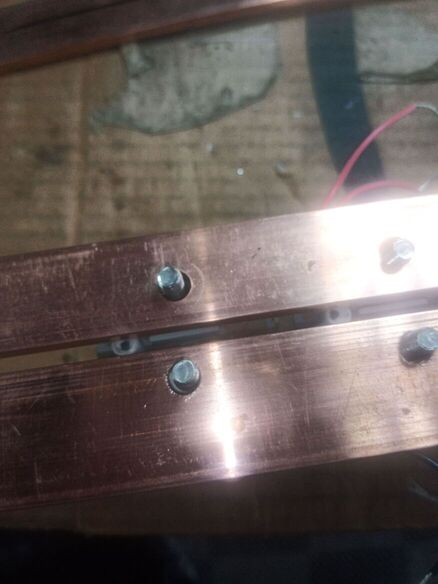
[picture p13: images/random/LEV100_Bus_Bars6.jpg]
  
</p>

<p align="center">
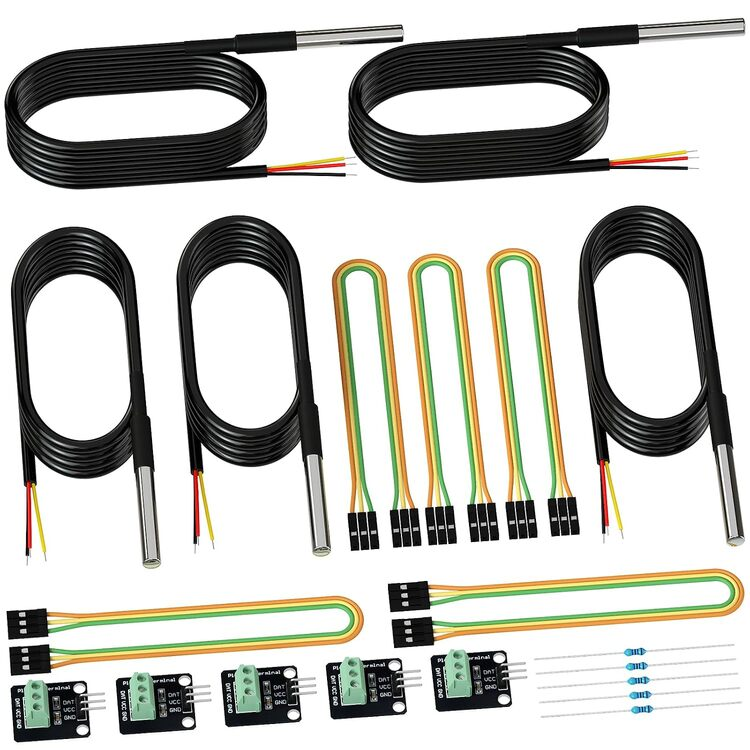
[picture p14: images/random/Temp_Sensors_Onewire.jpg]
  
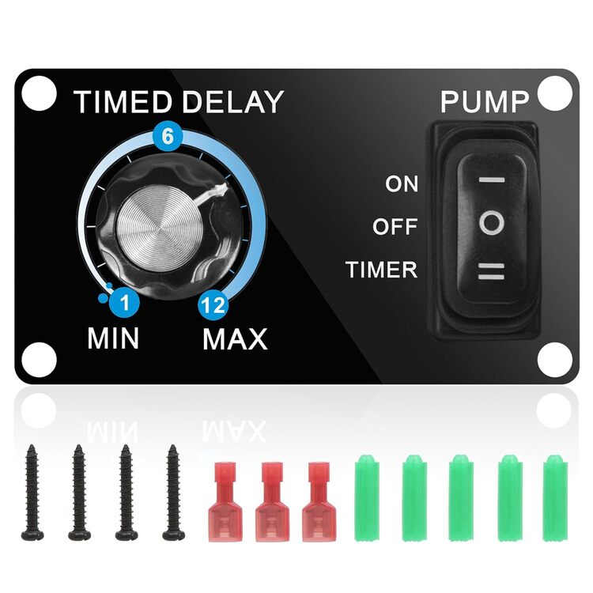
[picture p15: images/random/Timer_Switch.jpg]
  
</p>

<p align="center">
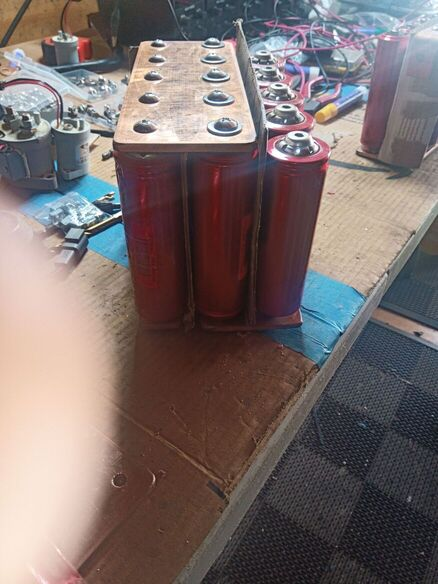
[picture p16: images/random/busbars_cell1.jpg]
  
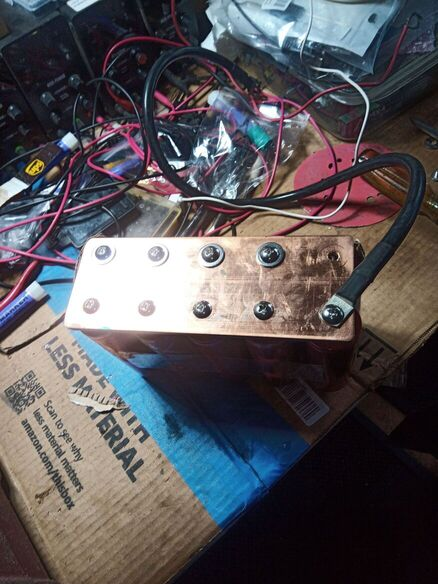
[picture p17: images/random/busbars_cell2.jpg]
  
</p>

<p align="center">
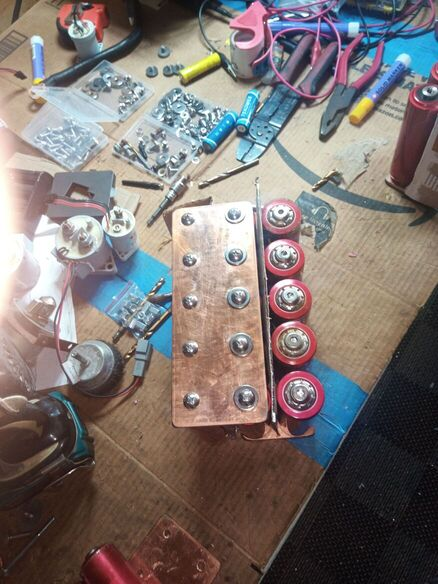
[picture p18: images/random/busbars_cell3.jpg]
  
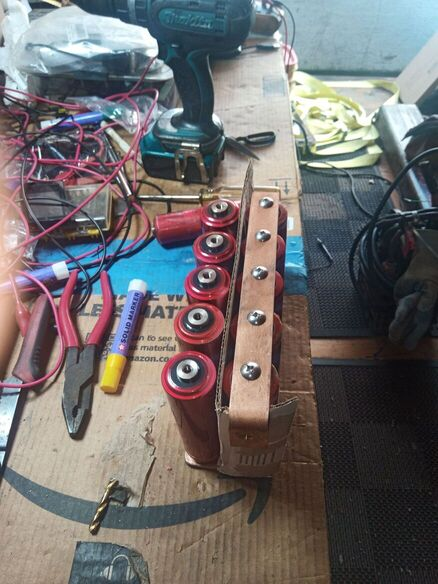
[picture p19: images/random/busbars_cell4.jpg]
  
</p>

<p align="center">
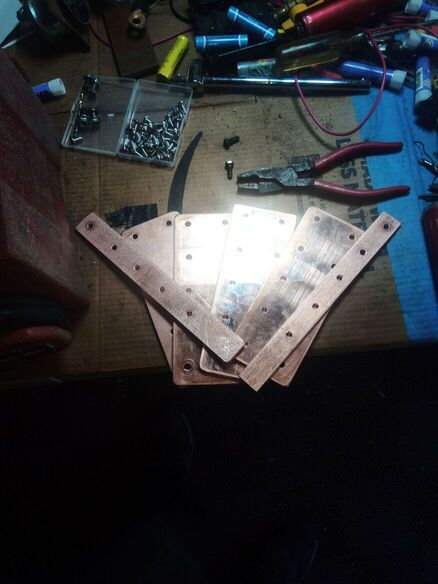
[picture p20: images/random/busbars_cell5.jpg]
  
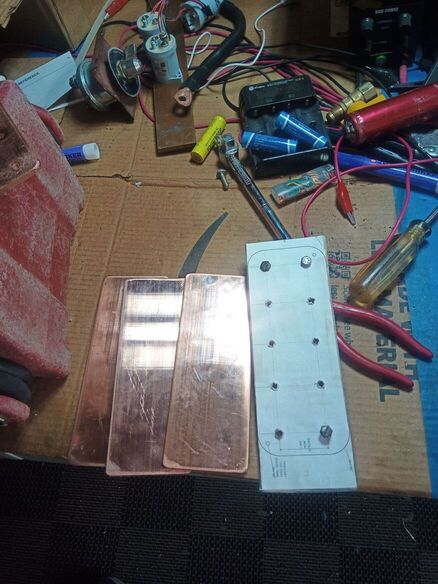
[picture p21: images/random/busbars_cell6.jpg]
  
</p>

<p align="center">
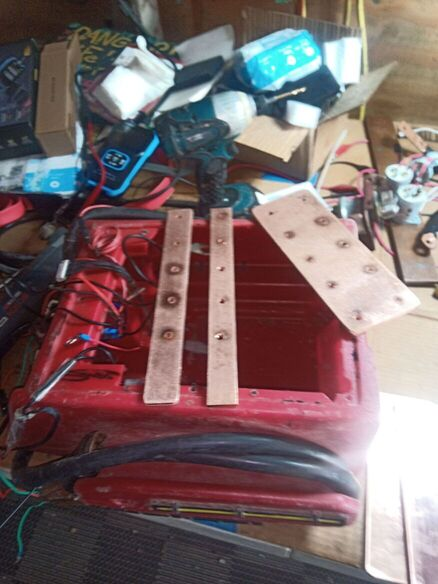
[picture p22: images/random/busbars_drilling.jpg]
  
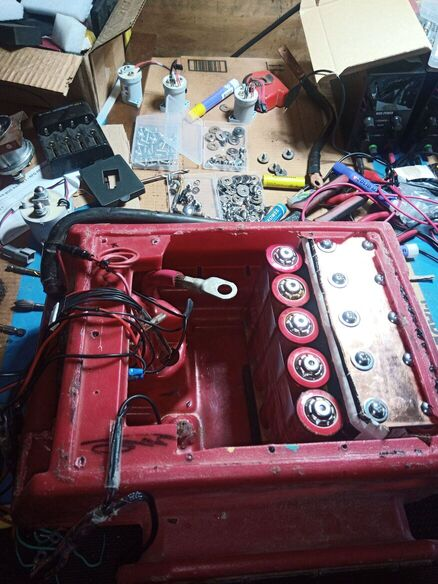
[picture p23: images/random/case_fitting1.jpg]
  
</p>

<p align="center">
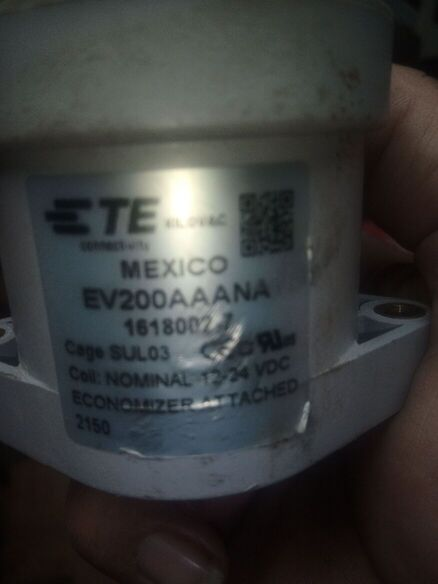
[picture p24: images/random/contactors_0_ev200.jpg]
  
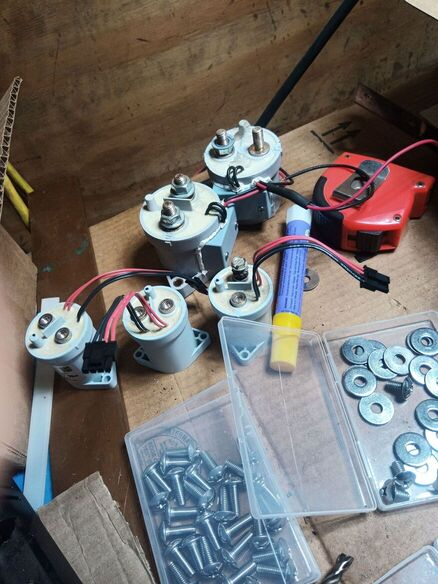
[picture p25: images/random/contactors_1.jpg]
  
</p>

<p align="center">
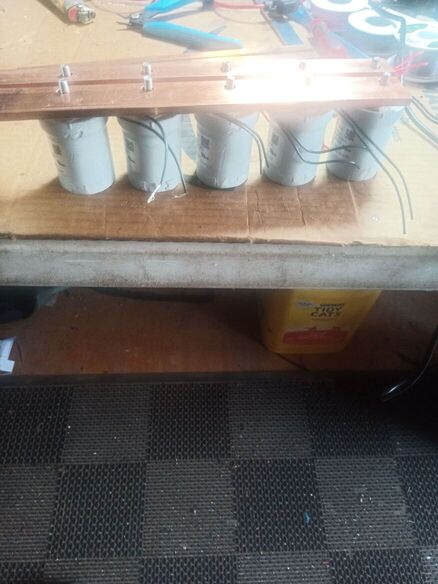
[picture p26: images/random/contactors_2_lez100.jpg]
  
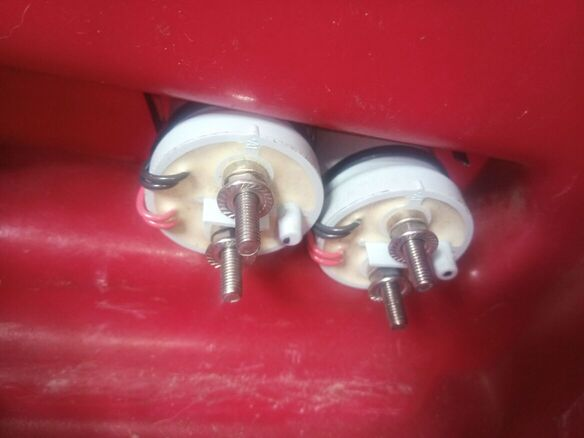
[picture p27: images/random/contactors_4_lez100.jpg]
  
</p>

<p align="center">
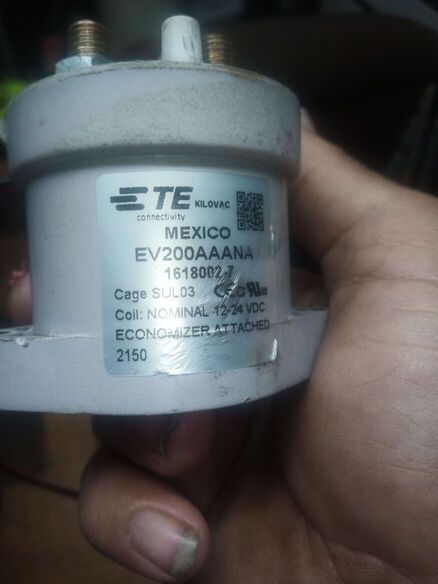
[picture p28: images/random/contactors_6_ev200.jpg]
  
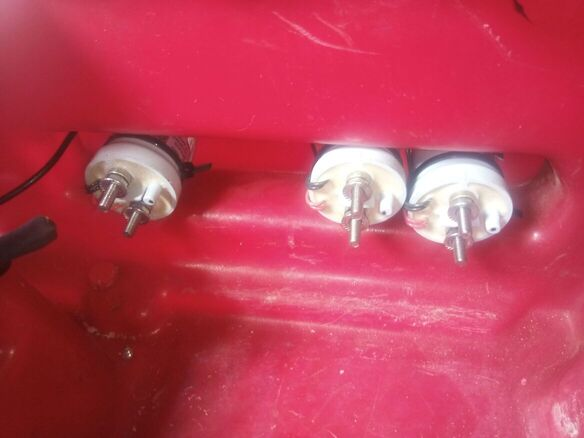
[picture p29: images/random/contactors_7_lez100.jpg]
  
</p>

<p align="center">
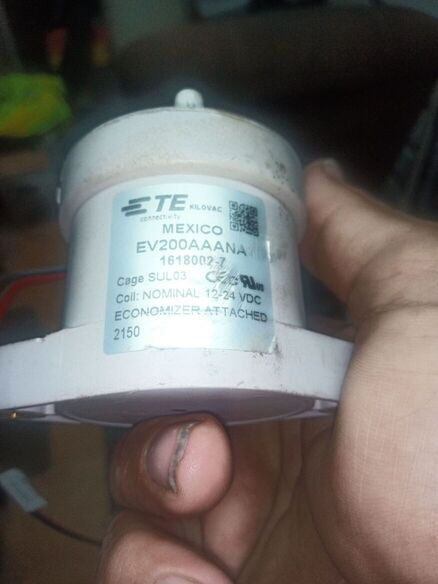
[picture p30: images/random/contactors_ev200.jpg]
  
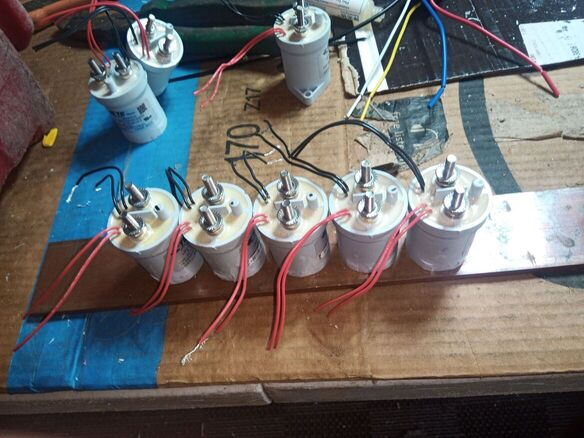
[picture p31: images/random/contactors_lez100.jpg]
  
</p>

<p align="center">
  
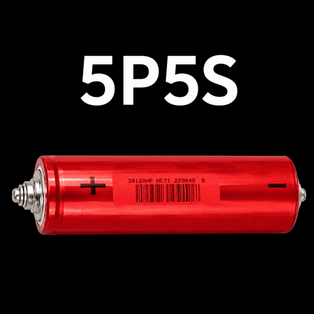
[picture p32: images/random/headway_38120.png]
  
</p>

<p align="center">
  
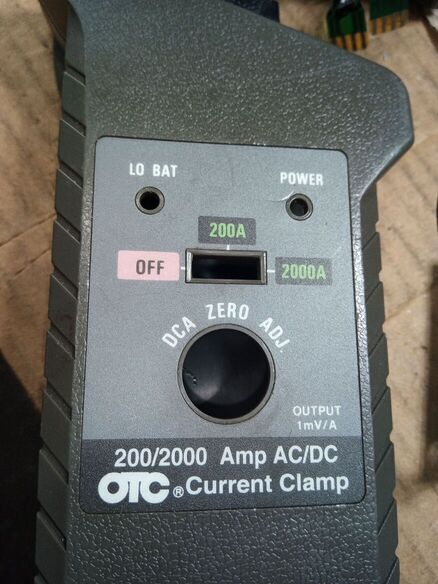
[picture p33: images/random/otc_case.jpg]
  
</p>

<p align="center">
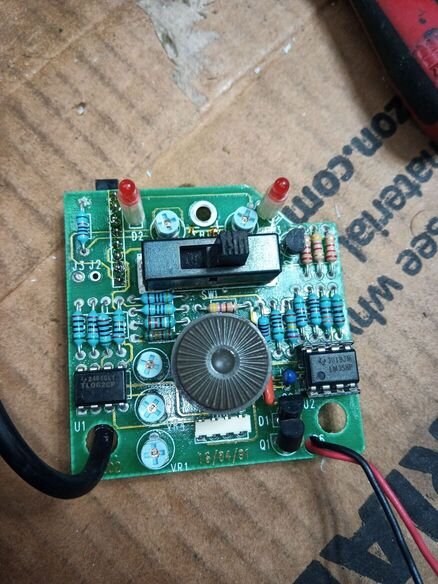
[picture p34: images/random/otc_cicuit_board.jpg]
  
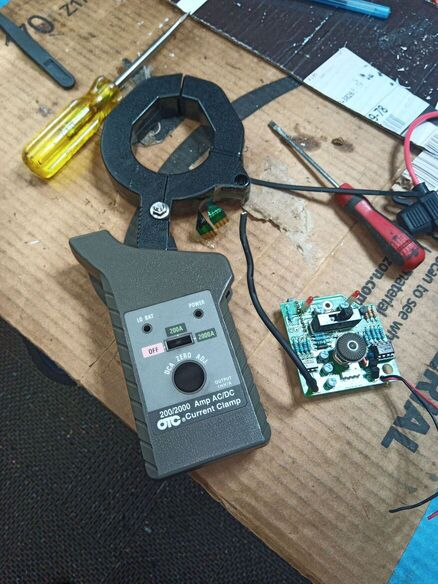
[picture p35: images/random/otc_oem_case.jpg]
  
</p>

<p align="center">
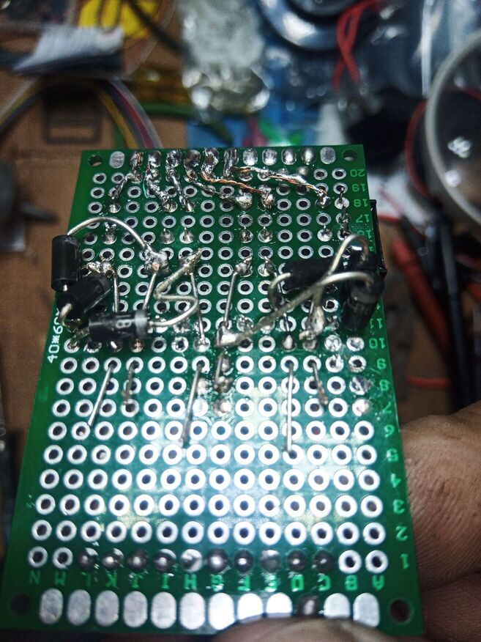
[picture p36: images/random/perfboard_001.jpg]
  
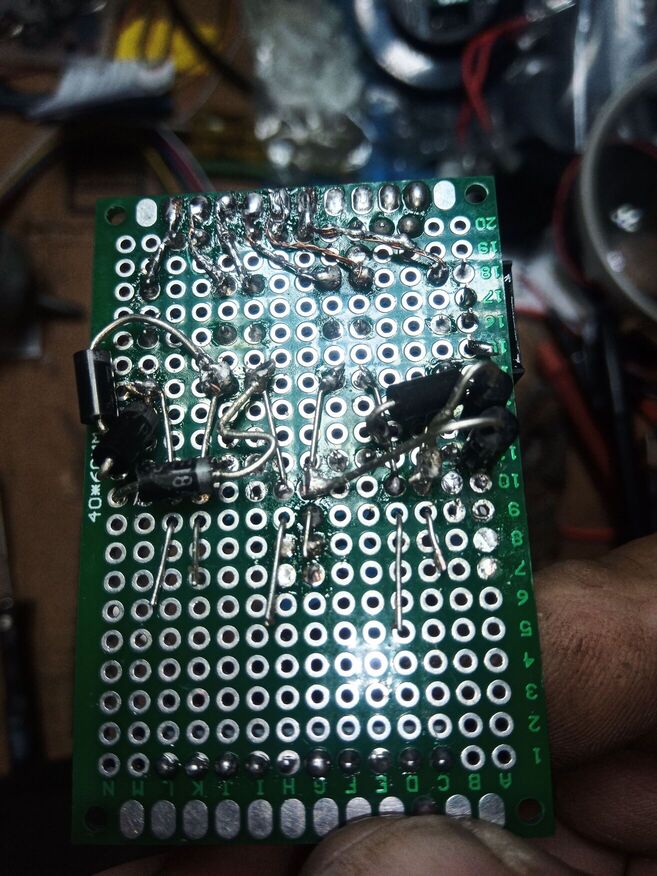
[picture p37: images/random/perfboard_002.jpg]
  
</p>

<p align="center">
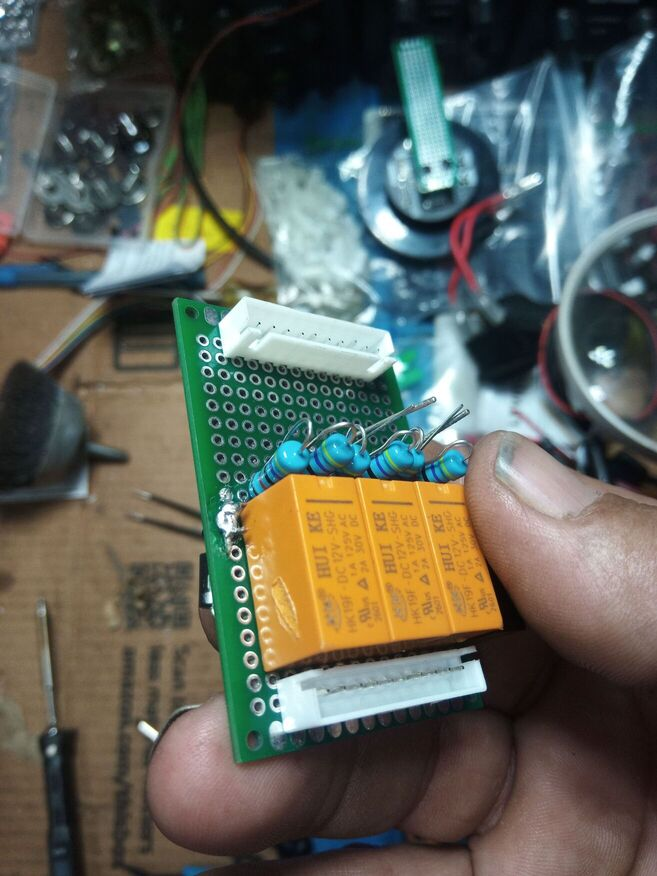
[picture p38: images/random/perfboard_003.jpg]
  
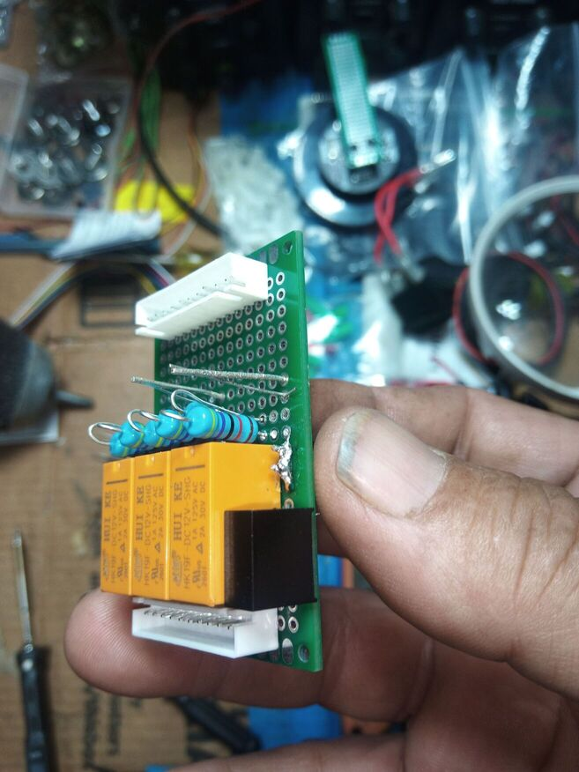
[picture p39: images/random/perfboard_004.jpg]
  
</p>

<p align="center">
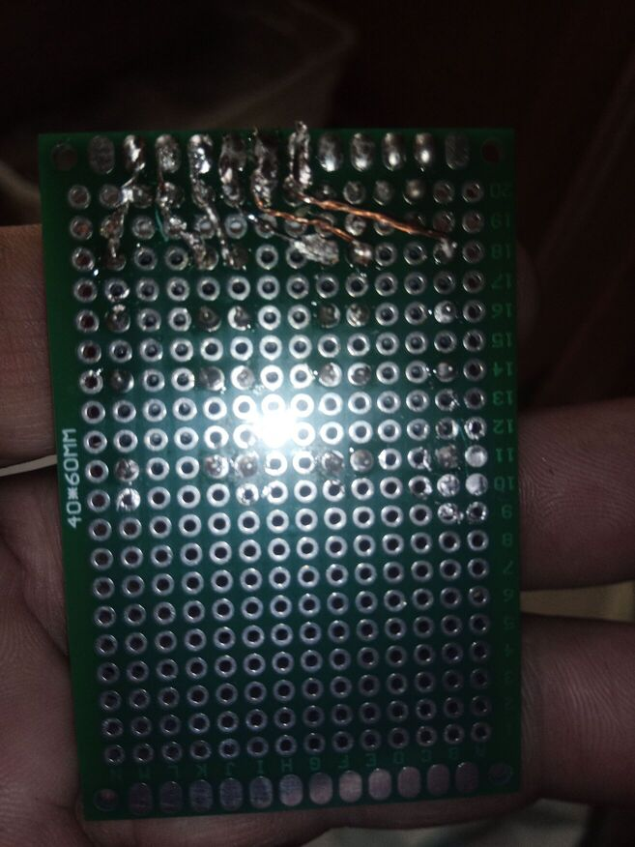
[picture p40: images/random/perfboard_005.jpg]
  
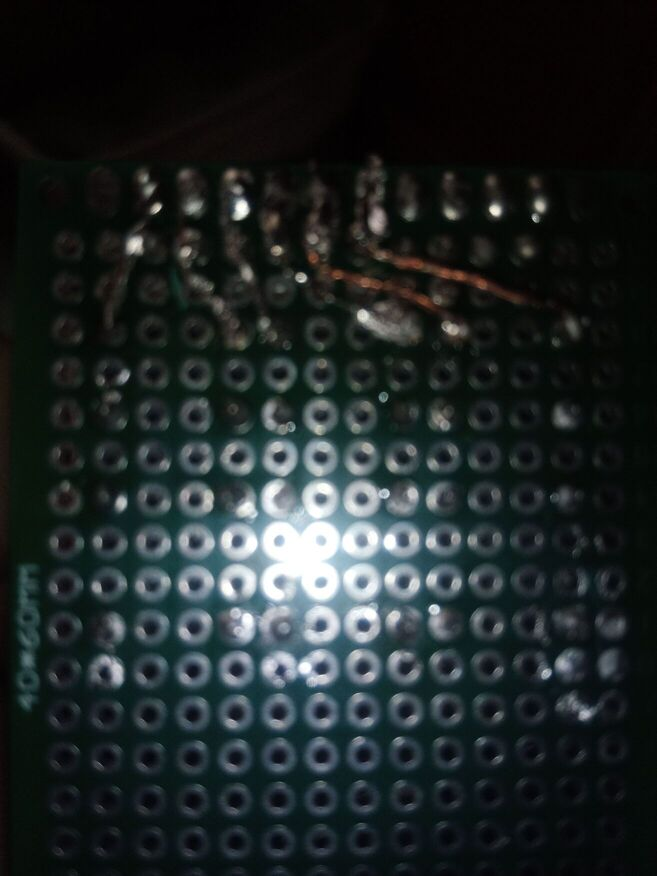
[picture p41: images/random/perfboard_006.jpg]
  
</p>

<p align="center">
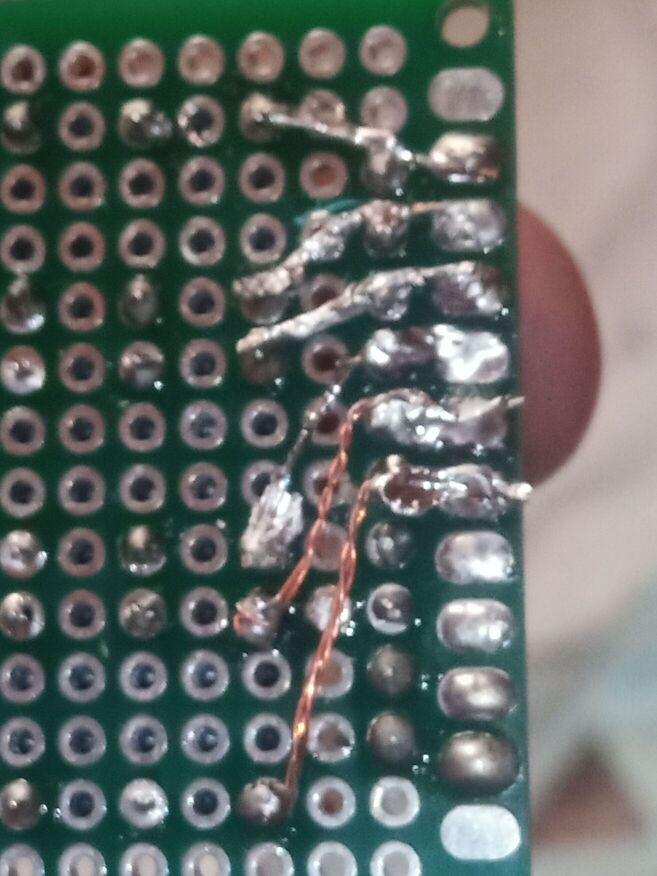
[picture p42: images/random/perfboard_007.jpg]
  
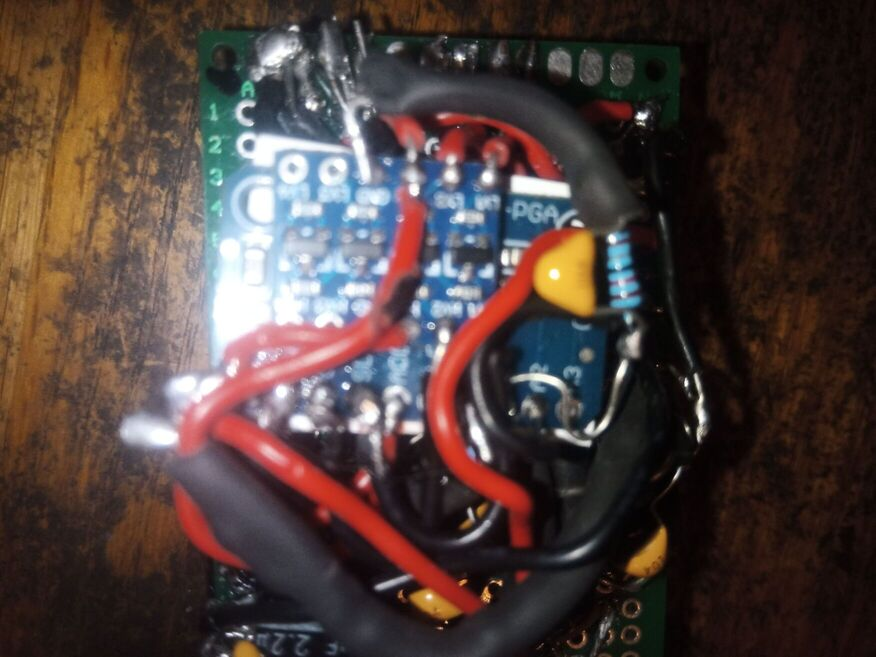
[picture p43: images/random/perfboard_031.jpg]
  
</p>

<p align="center">
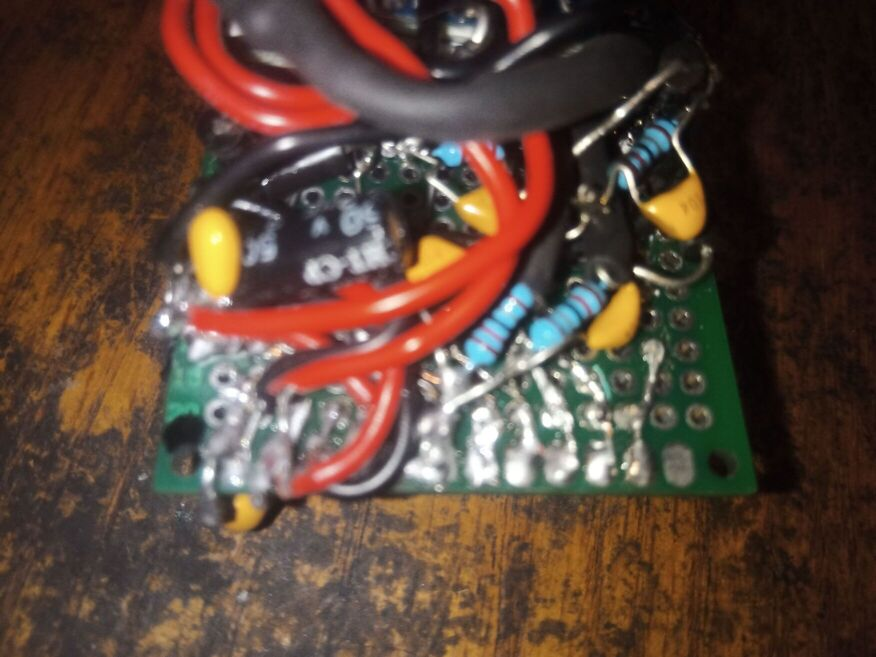
[picture p44: images/random/perfboard_323.jpg]
  
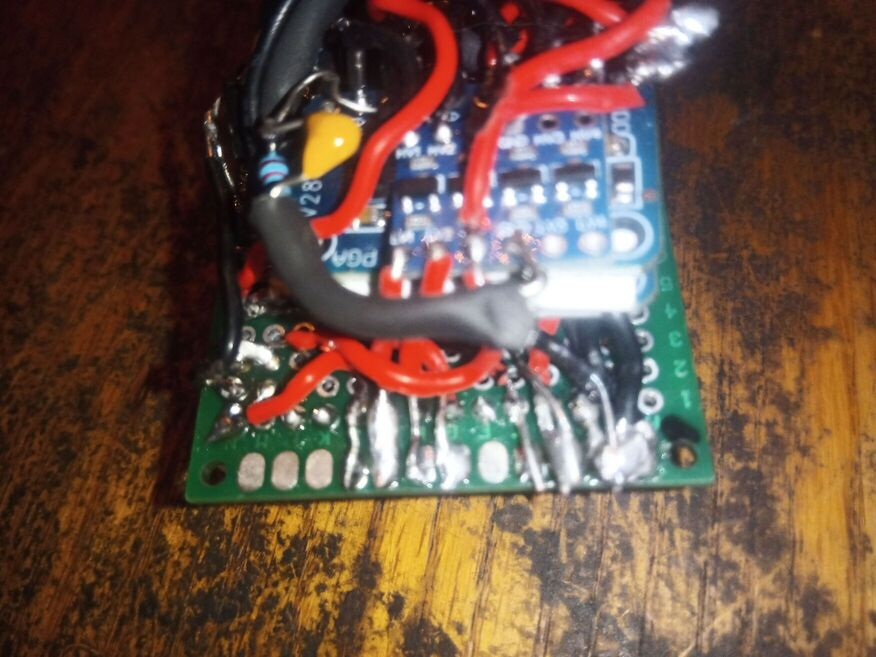
[picture p45: images/random/perfboard_457.jpg]
  
</p>

<p align="center">
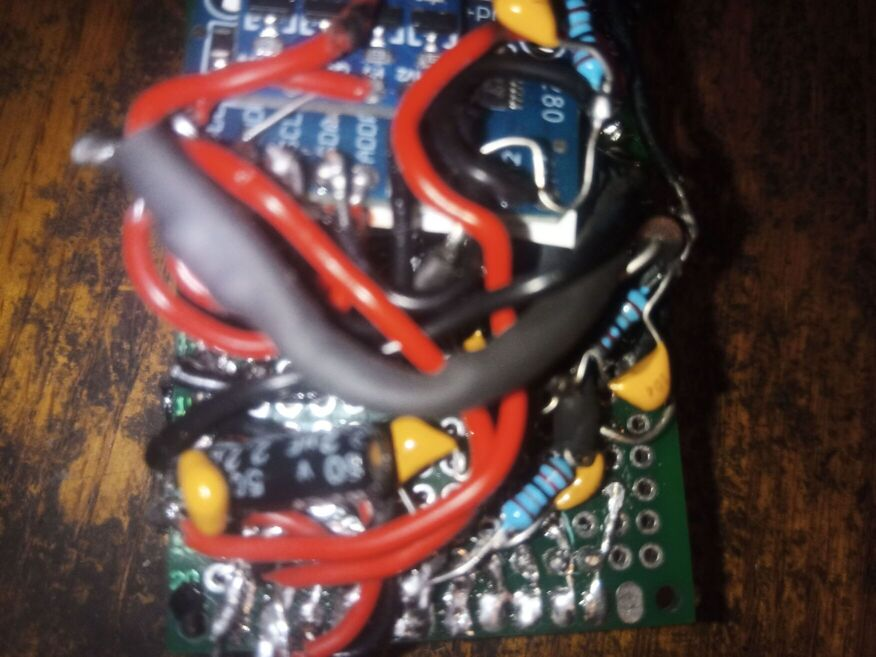
[picture p46: images/random/perfboard_489.jpg]
  
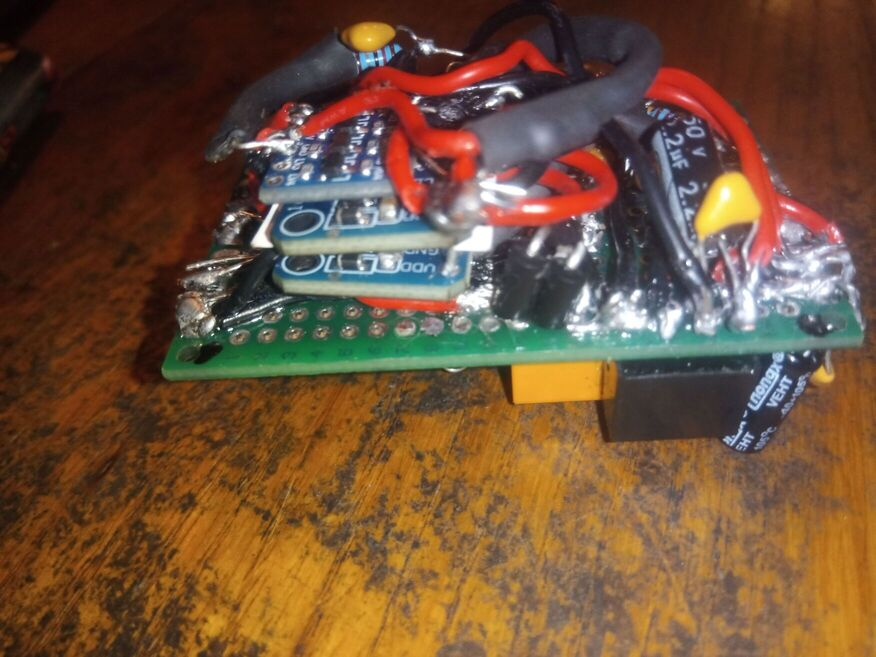
[picture p47: images/random/perfboard_548.jpg]
  
</p>

<p align="center">
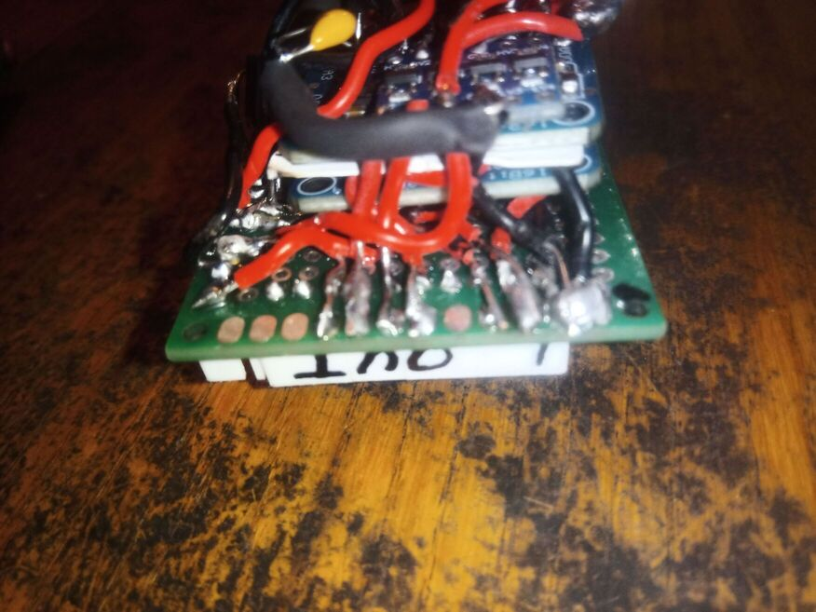
[picture p48: images/random/perfboard_789.jpg]
  
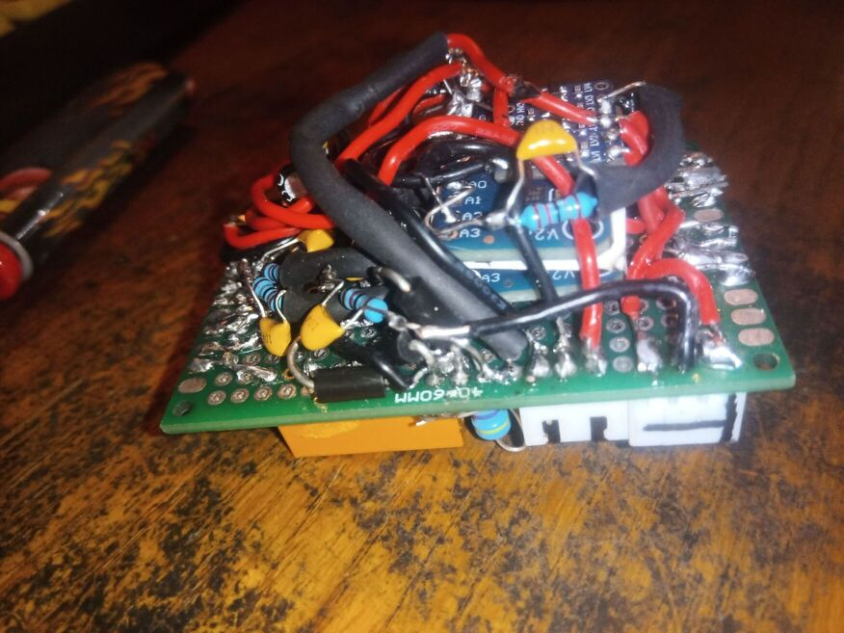
[picture p49: images/random/perfboard_852.jpg]
  
</p>

<p align="center">
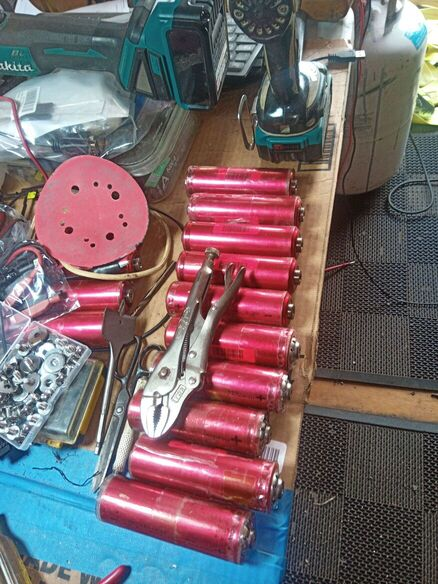
[picture p50: images/random/top_balance.jpg]
  
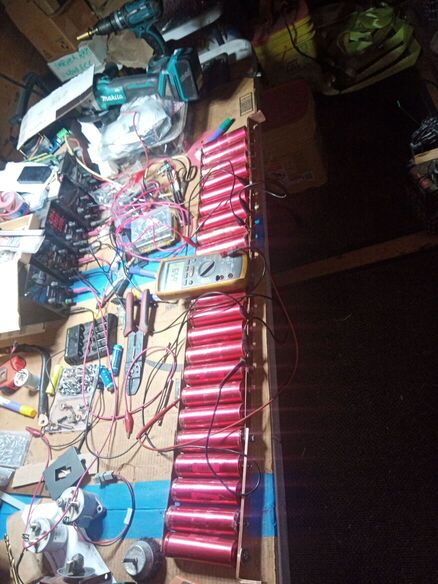
[picture p51: images/random/top_balance1.jpg]
  
</p>

<p align="center">
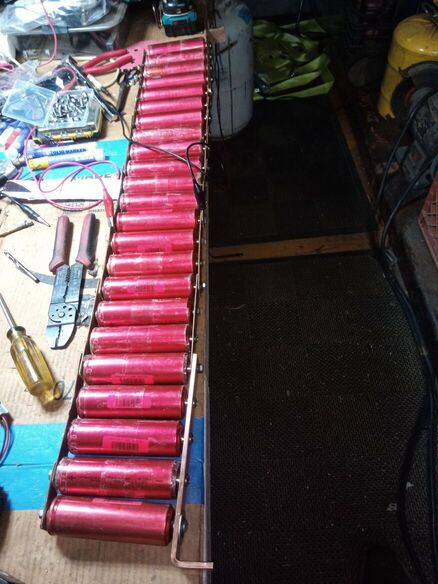
[picture p52: images/random/top_balance2.jpg]
  
  
</p>
