secarider/SNAPACK/actual sample of case.jpeg

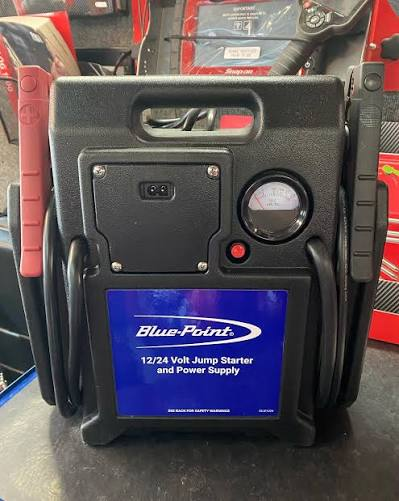
actual sample of case.jpeg
