secarider/SNAPACK/headway_38120.webp

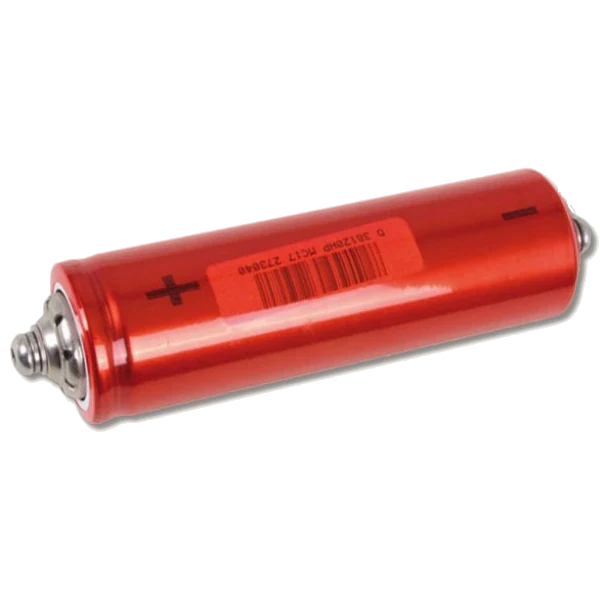
headway_38120.webp
