secarider/SNAPACK/images/random/B0509_5v_to_9v.jpg

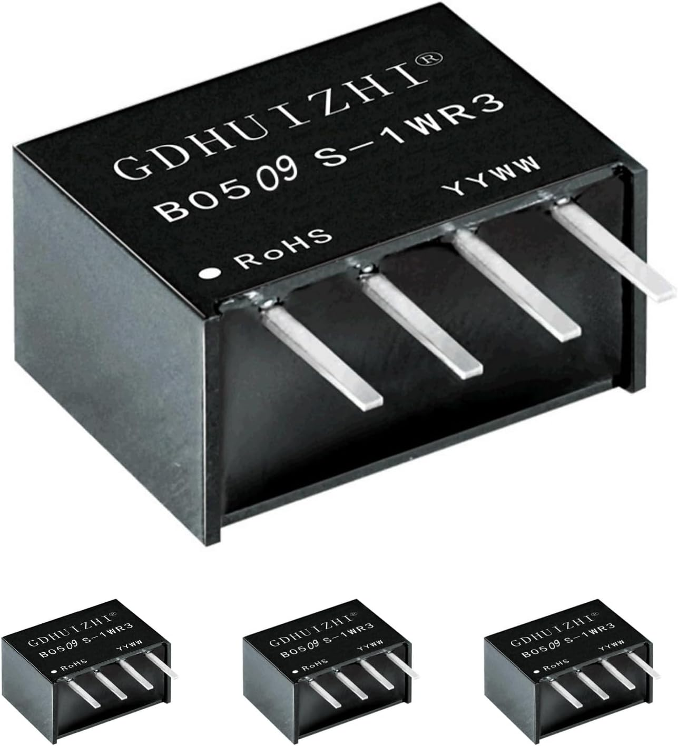
images/random/B0509_5v_to_9v.jpg
