secarider/SNAPACK/Documentation/11_Bill_Of_Materials.txt

============================================================
      11_BILL_OF_MATERIALS.TXT
============================================================

SNAPACK Hardware Specification

Status: Authoritative
Revision: Draft 08-09-2026
2026-09-10

============================================================
PURPOSE
============================================================

This Specification Defines The Major Components
Used Throughout SNAPACK.

============================================================
COMPONENT LIST
============================================================

Component
Boost Contactor

Manufacturer
TE Connectivity / Kilovac

Part Number
EV200AAANA

Quantity
2

Purpose
12V / 16V Switching

Reference
07_Contactor_Control.txt

------------------------------------------------------------

Component
Boost Contactor

Manufacturer
TE Connectivity / Kilovac

Part Numbers / Quantities
LEV100H5CNG03 — Qty 6
LEV100H5CNG02 — Qty 2

Quantity
8

Purpose
Main Battery Switching

Notes
Both Part Numbers Are LEV100H5CNG 24V-Coil High-Current Contactors
And Are Used Together In The Same Main Contactor / Busbar Assembly.

LEV100H5CNG03 Is Documented As The Auxiliary-Contact Version.
The Minor G02 / G03 Variant Difference Does Not Affect The
Main High-Current Switching Function Used By SNAPACK.

Reference
07_Contactor_Control.txt

------------------------------------------------------------

OTC 3500-01 Clamp Sensor
External Regulated 9V Power Supply

------------------------------------------------------------

Component
Main Display

Manufacturer
ELECROW ESP32-S3 Rotary Display

Part Number: DHE03921D

ASIN: B0G3TZGRC4

Quantity
1

Purpose
Primary Human Machine Interface

Reference
03_Display_Interface.txt

------------------------------------------------------------

Component
AMS1117-3.3 linear regulator
module

ASIN 	B07CP4P5XJ 

3.3V Regulator
3 Pins AMS1117-3.3 DC 4.75V-12V to 3.3V Voltage Regulated Buck Module 800mA

Manufacturer
Anmbest

Part Number
Anmbest_MD01

Quantity
1

Purpose
System 3.3V Rail

Reference
02_Power_Architecture.txt

------------------------------------------------------------

Component
ADS1115 16 Bit 4 Channel I2C Analog-to-Digital Converter

ASIN: 	B0DP43DDZG

Part Number: ADS1115

Purpose
Analog Data Acquisition

Reference
04_ADS1115_Analog_Front_End.txt

------------------------------------------------------------

Component
DPDT Relay 5V Coil 
2NO 2NC Mini PCB Power Relays HK19F-5V
8 Pin, DC 5V Coil, 1A 125VAC/2A 30VDC

------------------------------------------------------------

Adafruit DS2484 I2C to 1-Wire Bus Adapter Breakout - STEMMA QT / Qwiic JST SH 1mm

------------------------------------------------------------

Component
Temperature Sensor

Manufacturer
Maxim

Part Number: DS18B20

ASIN: ‎B0FLDRNB4R

Quantity
5

Purpose
Temperature Monitoring

Reference
06_Temperature_Monitoring.txt

------------------------------------------------------------
Component

Relay Module
ASIN 	B096M77HCJ
UPC 	701715466746

Manufacturer
AITRIP

Description
1-Channel 5V Opto-Isolated Relay Module
5V Quiescent Current: 4mA Working Current: 65mA Trigger Voltage: 0-2V Trigger Current: 2mA 

Purpose

Board 1 Authorization Interruption
Board 2 5th Cell Group (16v Boost) Charge Enable

Reference
08_Protection_And_Fault_Response.txt

============================================================
END OF SPECIFICATION
============================================================
