secarider/SNAPACK/Firmware/Current_Working/Archive/Build_Enviroment.txt

============================================================
SNAPACK — KNOWN-GOOD ARDUINO BUILD ENVIRONMENT
============================================================

IMPORTANT:
Do NOT blindly update Arduino libraries or the ESP32 board package.
SNAPACK was developed against the versions below.

BOARD / ESP32
-------------
Board:              ESP32S3 Dev Module
ESP32 Arduino Core: 2.0.14
Flash Size:         16 MB
PSRAM:              OPI PSRAM

PRIMARY LIBRARIES
-----------------
LVGL:                       8.3.6
GFX Library for Arduino:    1.3.1
OneWire:                    2.3.8
DallasTemperature:          4.0.6

OTHER ELECROW / DISPLAY LIBRARIES
---------------------------------
Adafruit_CST8XX_Library
PCF8574_library-master
Adafruit SSD1306:           2.5.9
Adafruit GFX Library:       1.11.x

NOTE:
For Elecrow-specific/display libraries where an exact version is
not recorded above, preserve the currently installed known-good
Elecrow versions rather than automatically upgrading them.

LVGL CONFIGURATION
------------------
SNAPACK uses the active Arduino LVGL installation at:

~/Arduino/libraries/lvgl

The Elecrow-compatible lv_conf.h configuration is also required.

FLASH / RECOVERY TOOL
---------------------
esptool: 5.3.1 installed via pipx

Known-good executable:
~/.local/bin/esptool

For the original 16 MB factory backup, --no-stub was required.

ARCHIVED SNAPACK ZIP FILES
--------------------------
Each numbered SNAPACK firmware ZIP is a complete source snapshot
of that revision.

The ZIP does NOT contain:
- Arduino IDE
- ESP32 Arduino Core
- installed Arduino libraries
- board packages / toolchains

Therefore this dependency/version sheet should be kept with the
firmware archive.

UPDATE POLICY
-------------
Do NOT assume newer versions are drop-in compatible.

In particular, preserve:
    ESP32 Arduino Core 2.0.14
    LVGL 8.3.6
    GFX Library for Arduino 1.3.1

A future upgrade should be treated as a deliberate SNAPACK
development change, not routine maintenance.
============================================================
