secarider/SNAPACK/(commit log)

2026-08-06 Add README.md for SNAPACK project documentation
    Added comprehensive documentation for the SNAPACK project, including hardware and software manifests, design philosophy, current firmware goals, and contribution guidelines.
2026-08-06 Update hardware manifest with new soldering tasks
    Added detailed hardware soldering tasks and specifications for the SNAPACK project, including installation of a 3.3V regulator, building additional voltage-divider channels, and connecting new ADS1115 inputs.
2026-08-06 Add control logic verification documentation
    Added detailed control logic verification documentation including state witnesses, expected agreements, disagreement examples, and case-mounted boost button functionality.
2026-08-06 Update Control Logic Verification with ADS1115 guidelines
    Added guidelines for using ADS1115 ALERT output with relay modules.
2026-08-06 Rename images.jpeg to actual sample of case.jpeg
2026-08-06 Rename actual sample of case.jpeg to images.jpeg
2026-08-07 Refactor pin descriptions for clarity
2026-08-08 Fix typo in LiFePO₄ to LiFePO4 in README
2026-08-08 Revise addressing instructions and switch notes
    Updated instructions for addressing boards and switch usage.
2026-08-09 Update hardware manifest with corrected pin assignments
2026-08-09 Update Bill of Materials with new components and details
2026-08-09 Revise purposes and manufacturer in BOM
    Updated purposes for battery switching components and corrected manufacturer details.
2026-08-10 Revise software manifest for firmware Version 1 updates
    Updated the software manifest to include new firmware architecture details, sensor monitoring features, and configuration settings for Version 1.
2026-08-10 Revise pin maps for 10 PIN OUTPUT HEADER
    Updated pin mapping information to reflect changes in pin usage and retired pins.
2026-08-11 Revise pin headers in documentation
    Updated pin header names and descriptions for clarity.
2026-08-11 Clarify pin descriptions in documentation
2026-08-14 Add proposed hardware design concepts for evaluation
    Added proposed design concepts for hardware evaluation, including 24V monitoring, BMS isolation relay wiring, processor manual override, and ambient light sensor integration.
2026-08-16 Revise pin map format and add ADS1115 channel map
    Updated pin numbering format and added authoritative channel map for ADS1115.
2026-08-16 Revise ADS1115 channel assignments and connections
    Updated ADS1115 channel assignments and clarified connections for boards.
2026-08-16 Revise ADS1115 Analog Front End documentation
    Updated ADS1115 documentation with additional details on board configurations and connections.
2026-08-16 Update hardware manifest with ADS1115 connections
    Added connections for ADS1115 Board 2 in hardware manifest.
2026-08-16 Fix pin mapping descriptions in documentation
2026-08-17 Update ADS1115 documentation for clarity
    Clarified descriptions for board connections and relay module.
2026-08-17 Revise hardware manifest with new design proposals
    Added notes on hardware design concepts and proposed features for Cell-5 charging and recovery, including manual override and automatic disconnect logic.
2026-08-17 Restore relay pin mapping details in documentation
    Re-added relay pin mapping information for 12V and 16V police relays.
2026-09-10 Update software manifest with system status and features
    Added detailed status updates and functionality descriptions for various components of the SNAPACK system, including temperature monitoring, current sensing, and UI interactions.
2026-09-11 Revise hardware manifest for clarity and accuracy
    Updated hardware manifest with clarifications and corrections throughout the document, including changes to specifications, wiring instructions, and component details.
2026-09-11 Revise authoritative pin map documentation
    Updated pin map documentation for clarity and accuracy, including corrections to connector descriptions and pin allocations.
2026-09-11 Revise power architecture documentation
    Updated power rail specifications and removed redundant sections on isolated supplies and ground systems.
2026-09-11 Revise display power and function descriptions
    Updated display power specifications and clarified display functions.
2026-09-11 Revise ADS1115 documentation for clarity and accuracy
    Updated documentation for ADS1115 Analog Front End, including channel allocation, voltage monitoring, and protection network details.
2026-09-11 Revise power supply information and clean up content
    Updated power supply details and removed verification section.
2026-09-11 Update documentation for current monitoring specifications
2026-09-11 Document Revision C changes in hardware log
    Added Revision C details including changes to ADS1115 operation, removal of I2C level shifter, and updates to voltage divider architecture.
2026-09-11 Update power architecture documentation
    Removed ADS1115 Modules from the 5V and 3.3V rail sections.
2026-09-11 Revise last updated date and device mentions
    Updated last modified date and corrected device references.
2026-09-11 Revise ADS1115 Analog Front End documentation
    Updated documentation for ADS1115 Analog Front End, including changes to board descriptions, design rules, and input protection details.
